lab11/hijack/hardware/hijack_power_supply/rev_a/HIJACK_A.pdf

A

A

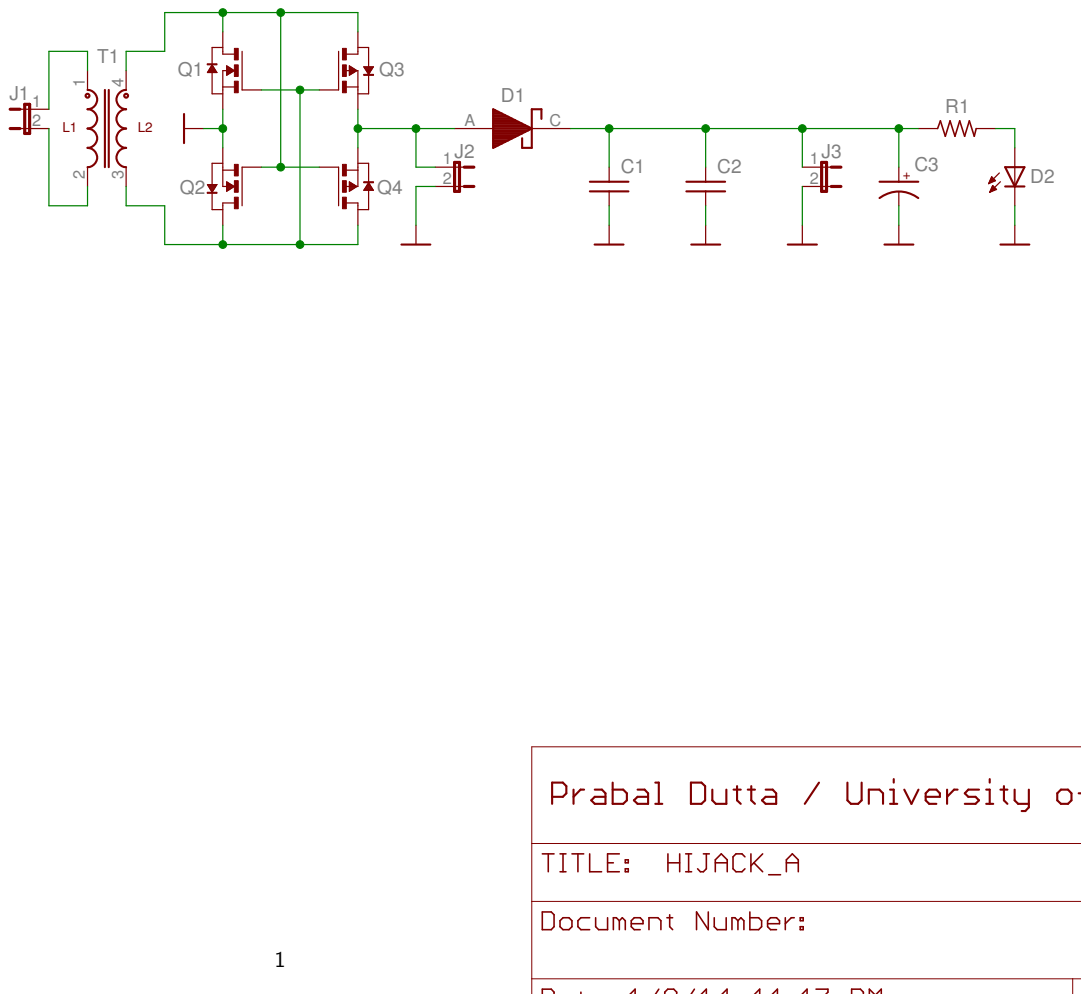
[picture p2: page 1]

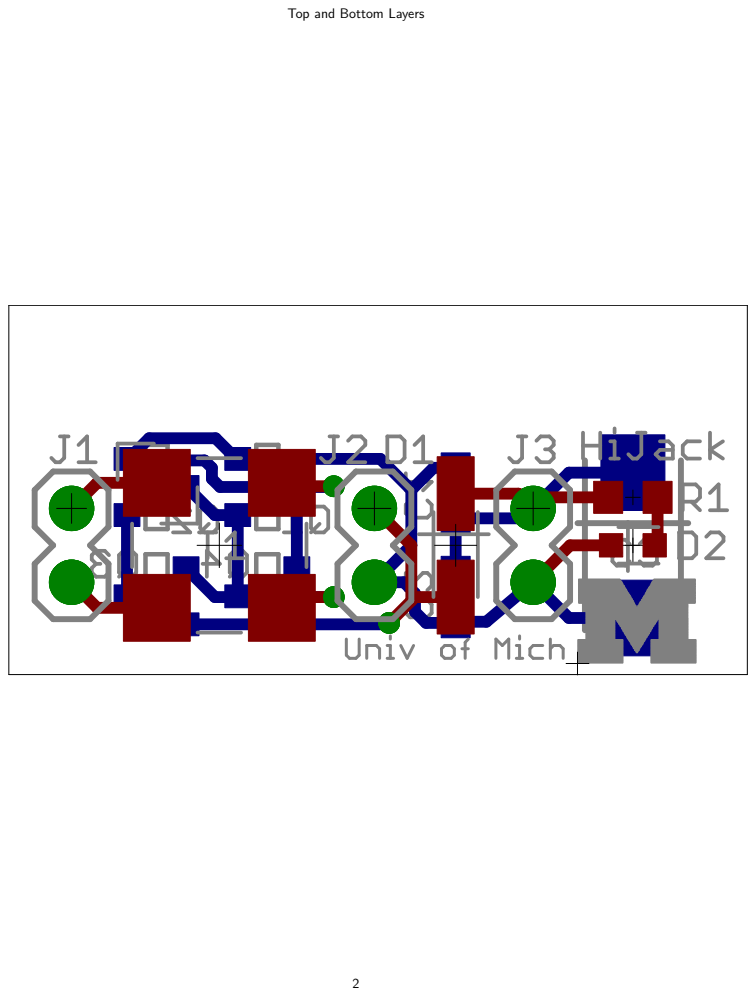
[picture p3: page 2]

Top and Bottom Layers

Top Layer

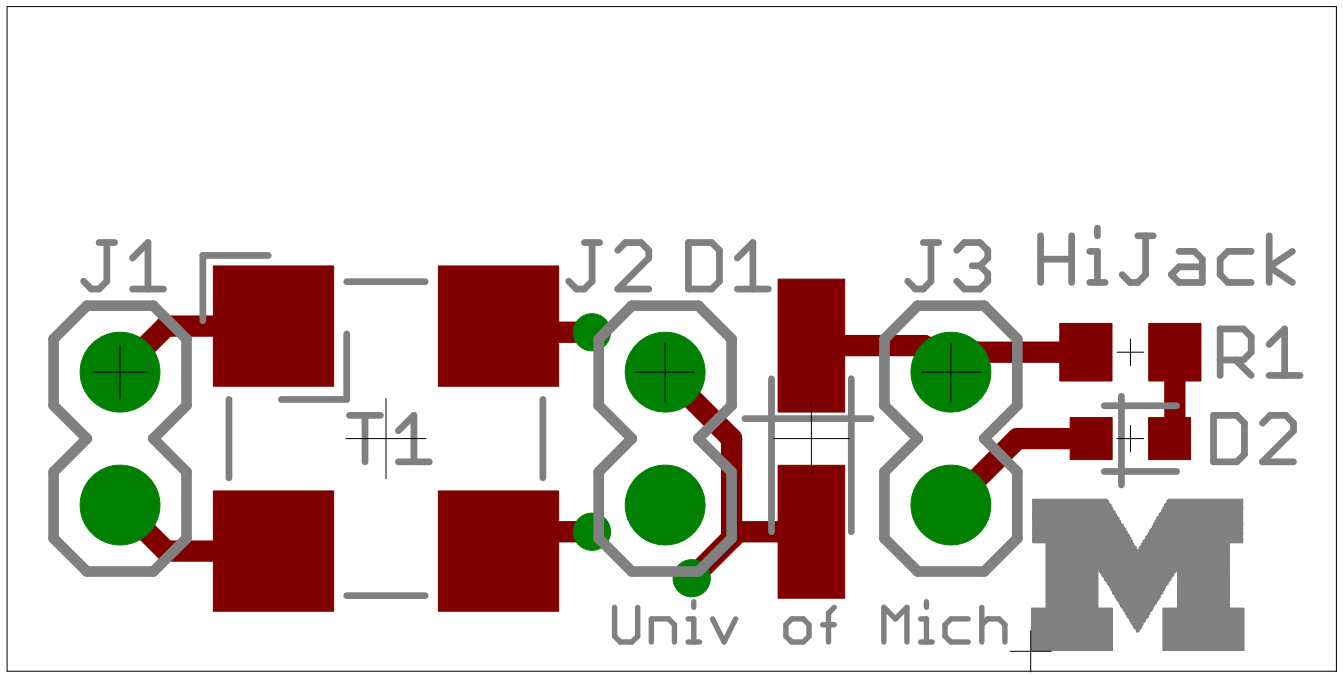
[picture p4: figure]

Bottom Layer

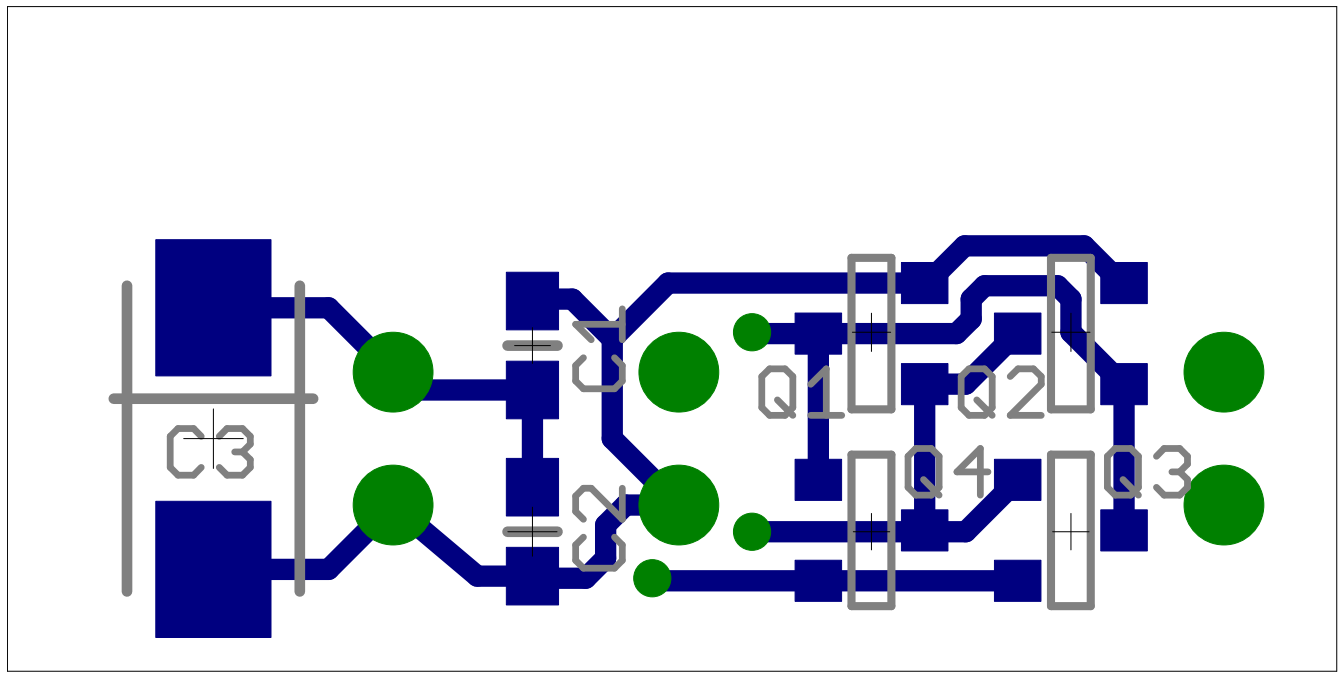
[picture p5: figure]

Top Copper Layer

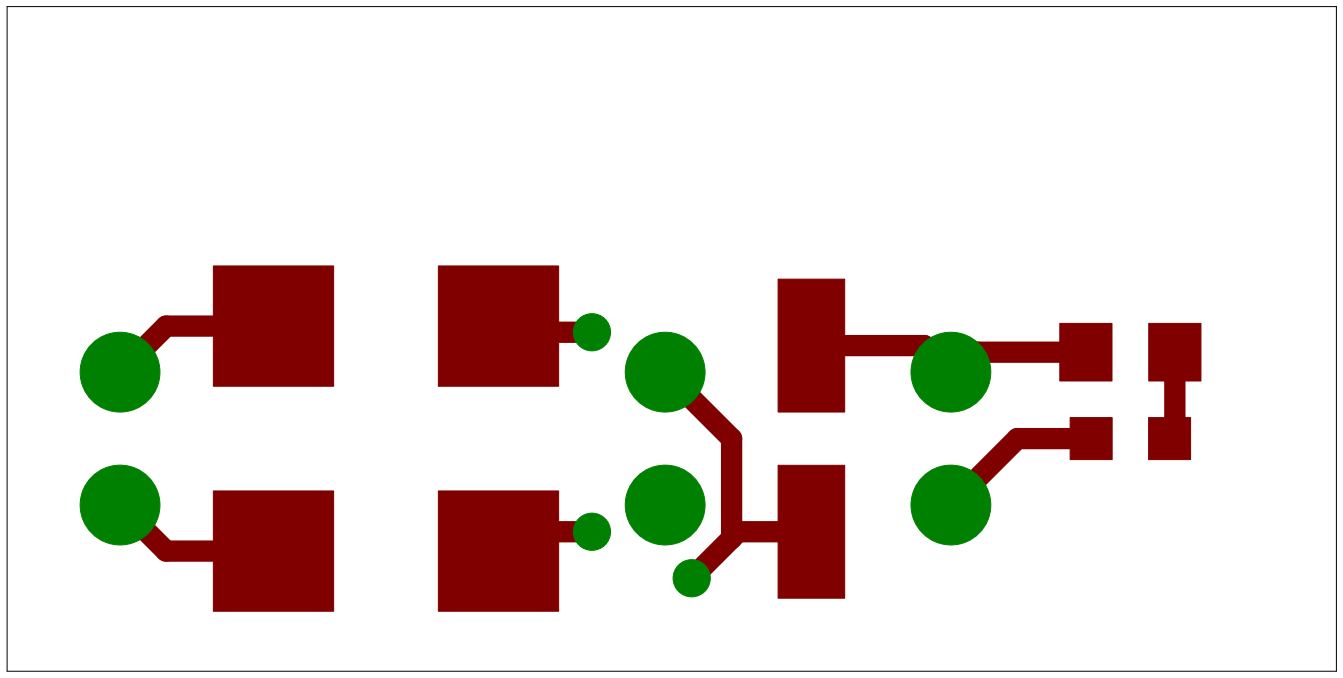
[picture p6: figure]

Bottom Copper Layer

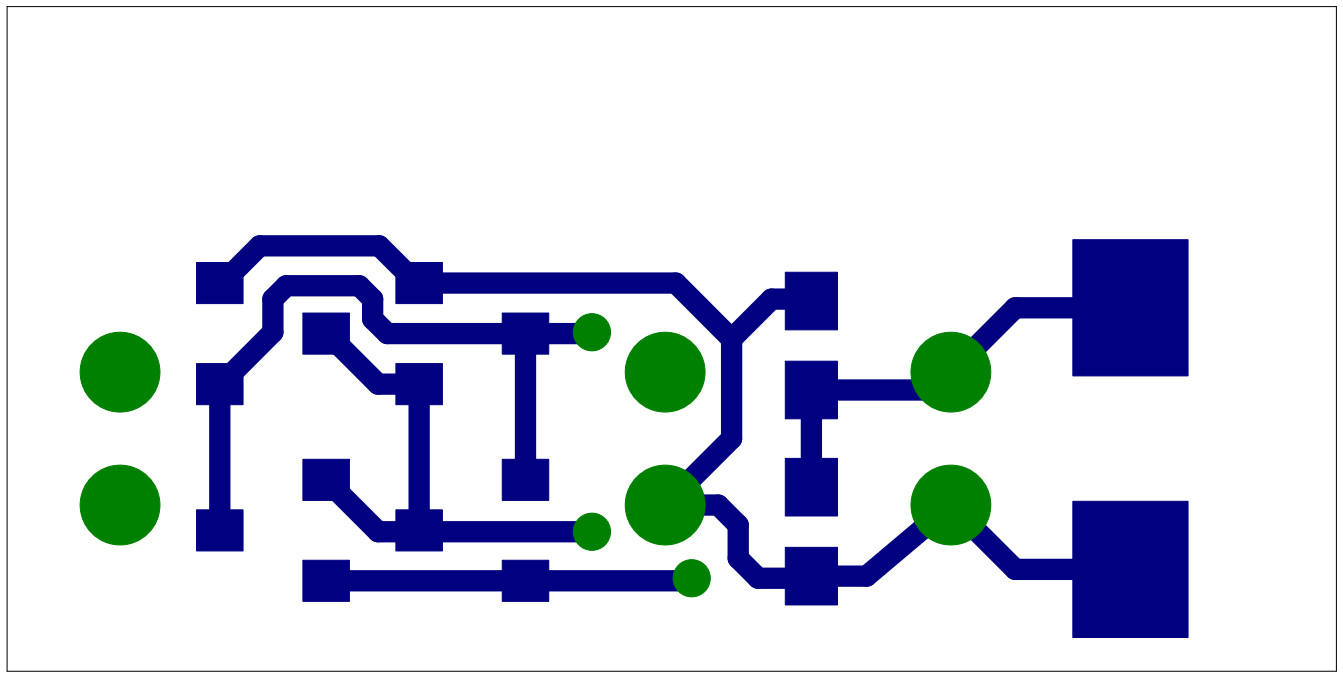
[picture p7: figure]

Top Paste Layer with Silkscreen

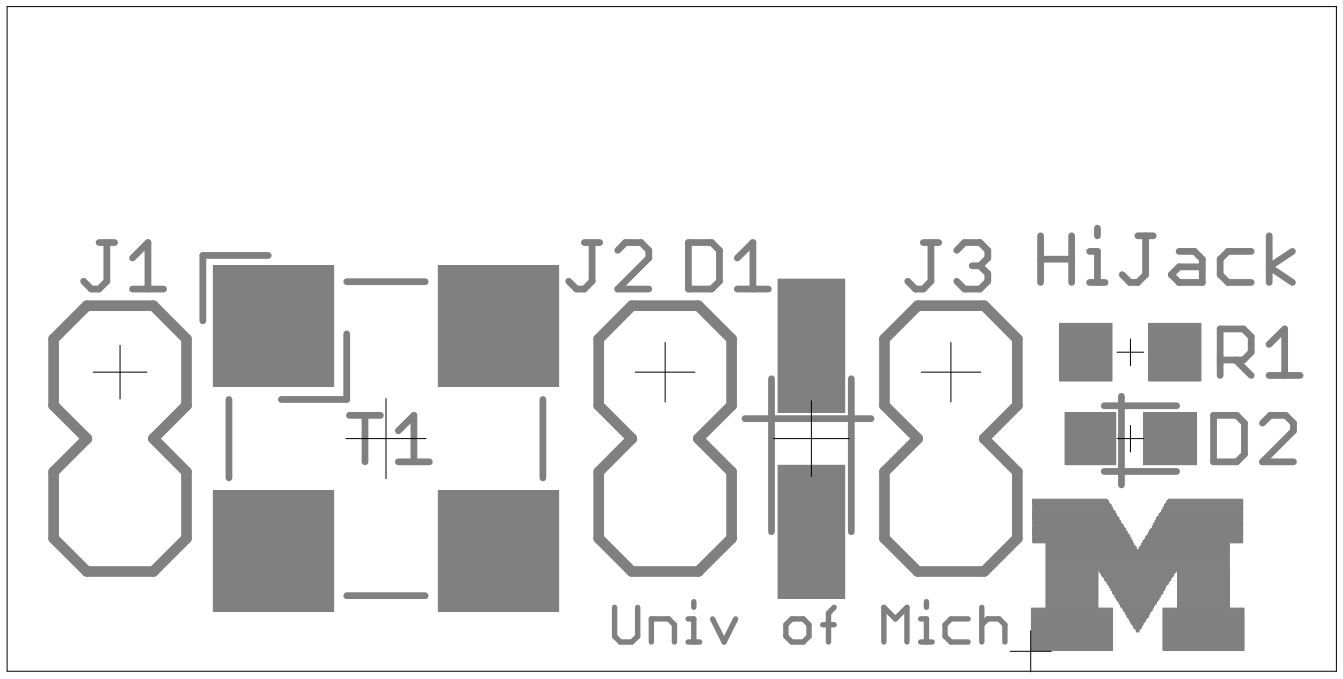
[picture p8: figure]

Bottom Paste Layer with Silkscreen

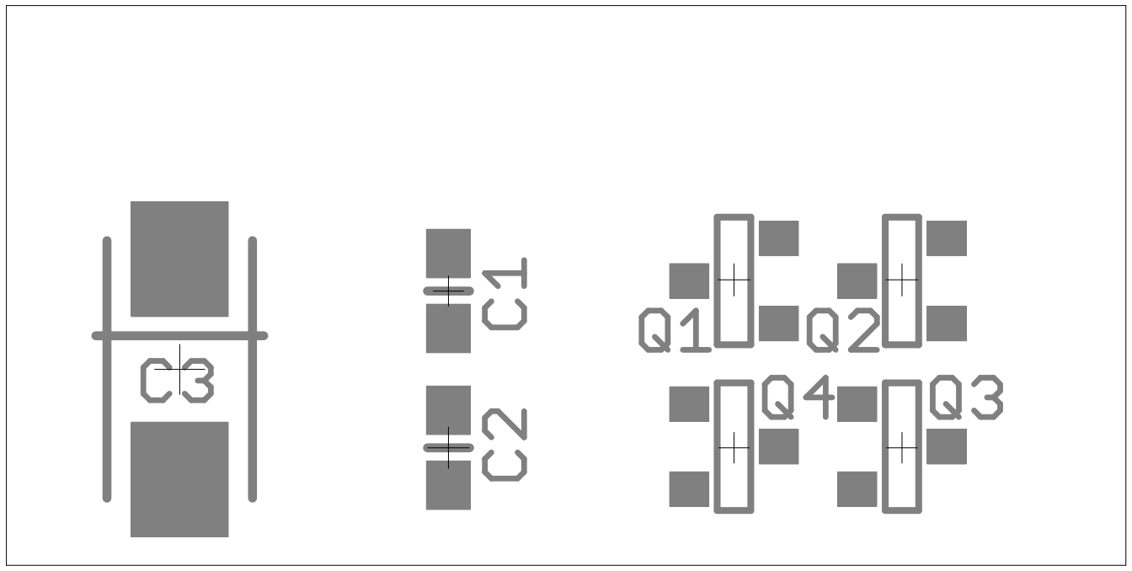
[picture p9: figure]
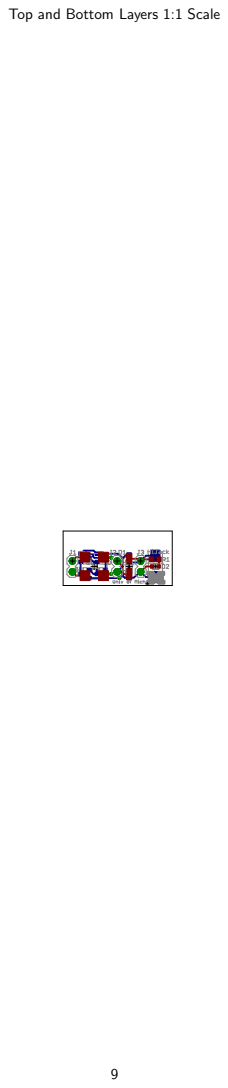
[picture p10: page 9]

Top and Bottom Layers 1:1 Scale

Top Layer 1:1 Scale

Bottom Copper Layer 1:1 Scale
