lab11/hijack/hardware/hijack_power_supply/rev_a/HIJACK_A_pcb.png

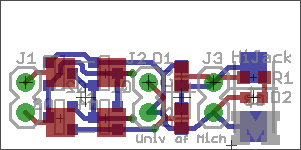
hardware/hijack_power_supply/rev_a/HIJACK_A_pcb.png
