lab11/hijack/hardware/hijack_programmer/rev_a/HiJack_Programmer_pcb.png

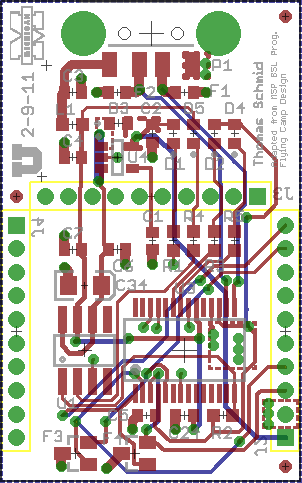
hardware/hijack_programmer/rev_a/HiJack_Programmer_pcb.png
