lab11/hijack/hardware/hijack_protoboard/rev_a/HiJack_ProtoBoard_pcb.png

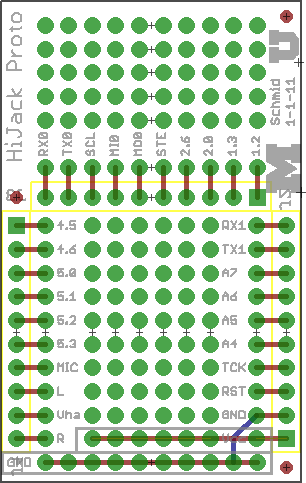
hardware/hijack_protoboard/rev_a/HiJack_ProtoBoard_pcb.png
