lab11/hijack/hardware/hijack_qfn/rev_b/HIJACK_C_pcb.png

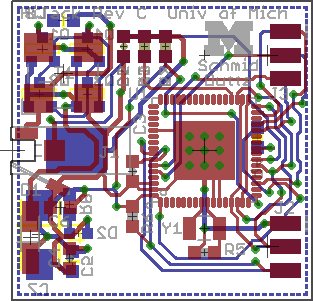
hardware/hijack_qfn/rev_b/HIJACK_C_pcb.png
