lab11/hijack/case/case_v3.stl

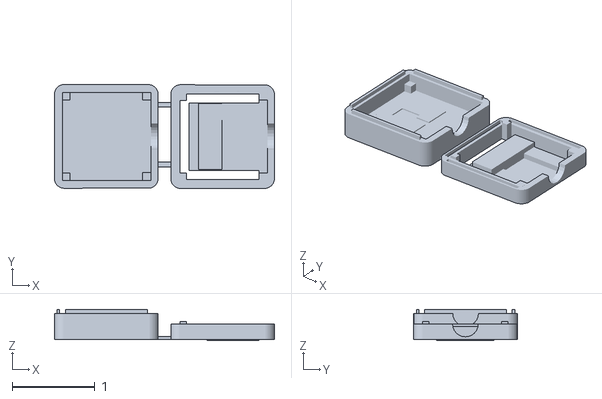
[picture p15: CAD file, 2014-01-10]
case/case_v3.stl
2.65 x 1.25 x 0.375
