lab11/hijack/(list of files, cad)

Other CAD files:
case/M.skp
case/case v1.skp
case/case_v2.skp
case/case_v3.skp
case/case_v4.skp
case/case_v5.skp
case/case_v6.skp
case/case_v6_bot.skp
case/case_v6_top.skp
case/case_v7_bot.skp
case/case_v7_top.skp
case/underside small.skp
case/underside.skp
