lab11/hijack/hardware/hijack_qfn/rev_b/HIJACK_C.pdf

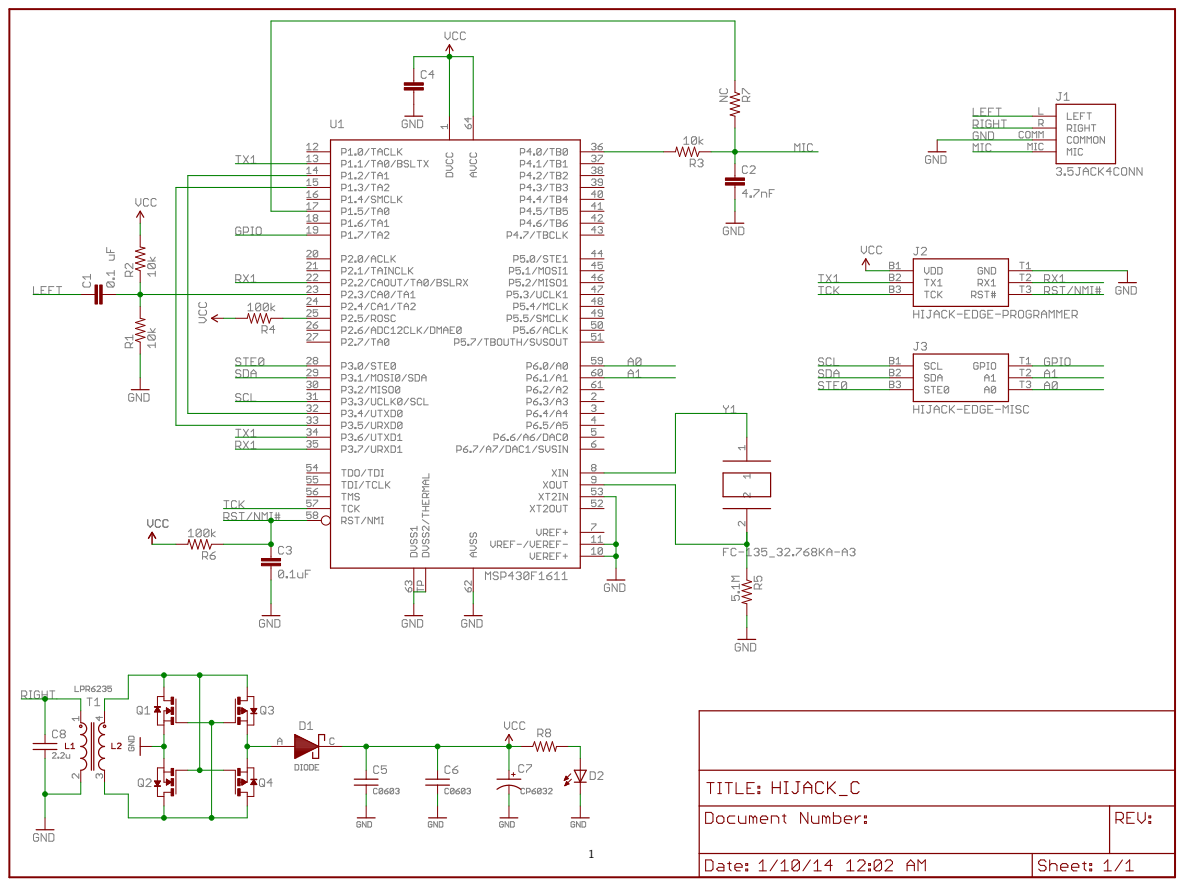
[picture p16: page 1]

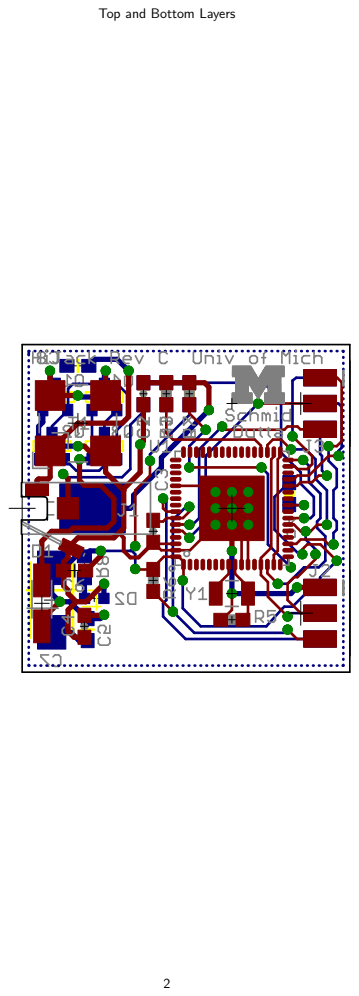
[picture p17: page 2]

Top and Bottom Layers

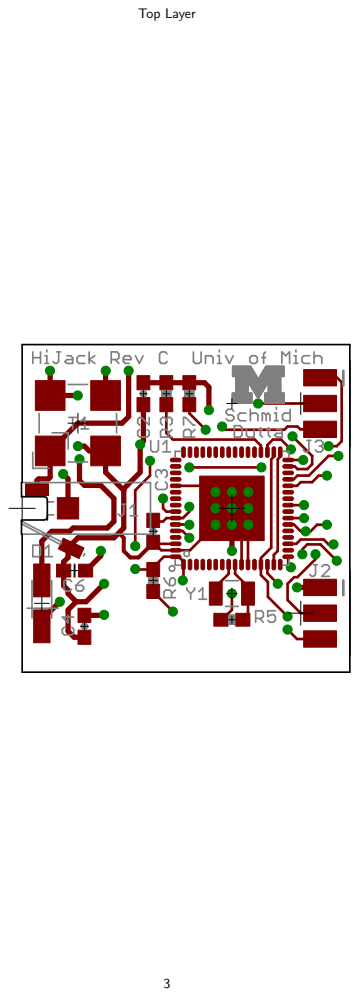
[picture p18: page 3]
Top Layer

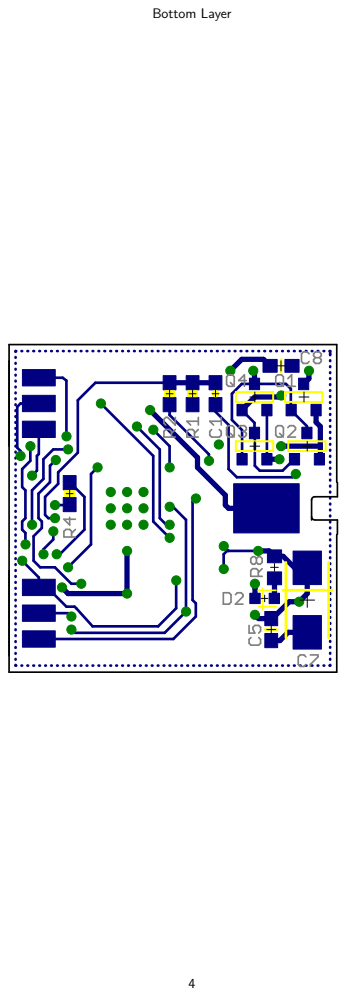
[picture p19: page 4]
Bottom Layer

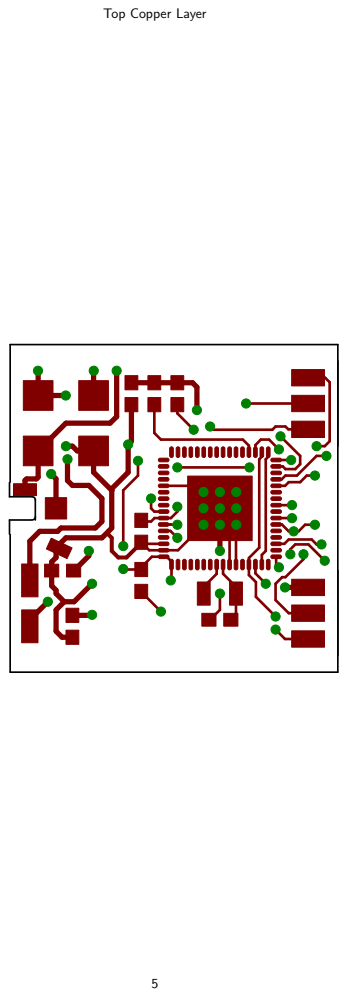
[picture p20: page 5]

Top Copper Layer

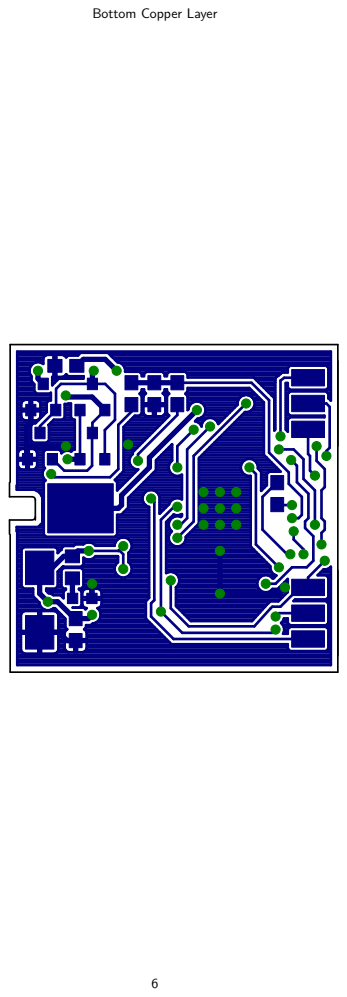
[picture p21: page 6]

Bottom Copper Layer

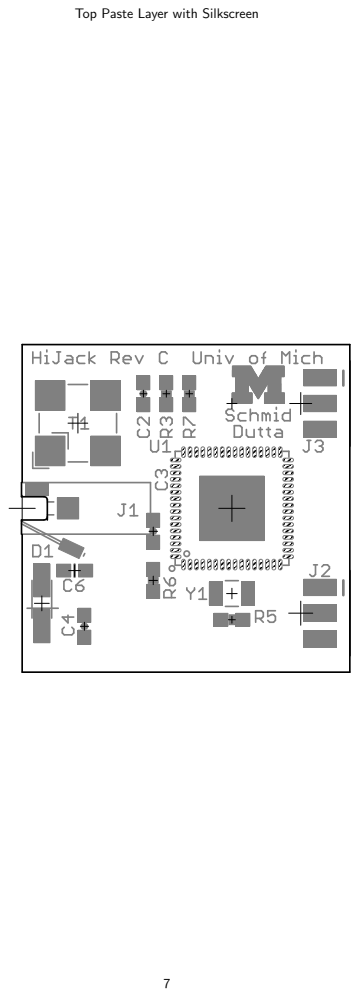
[picture p22: page 7]

Top Paste Layer with Silkscreen

Bottom Paste Layer with Silkscreen

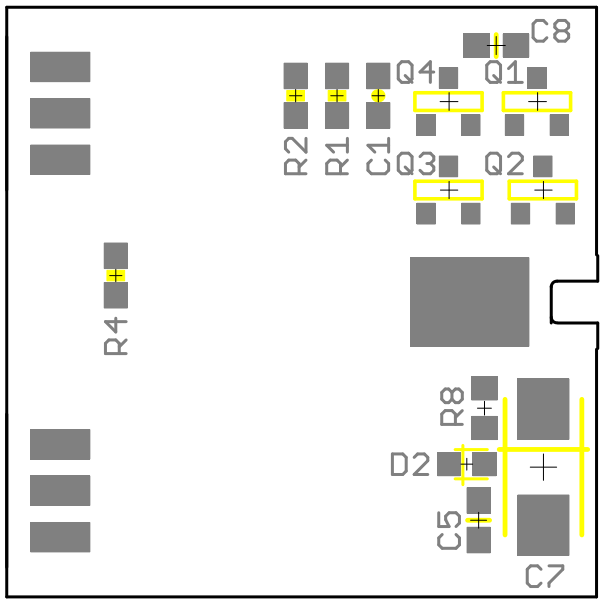
[picture p23: figure]
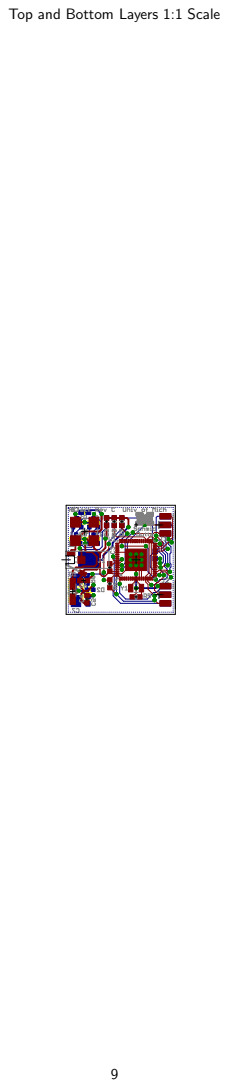
[picture p24: page 9]

Top and Bottom Layers 1:1 Scale

Top Layer 1:1 Scale

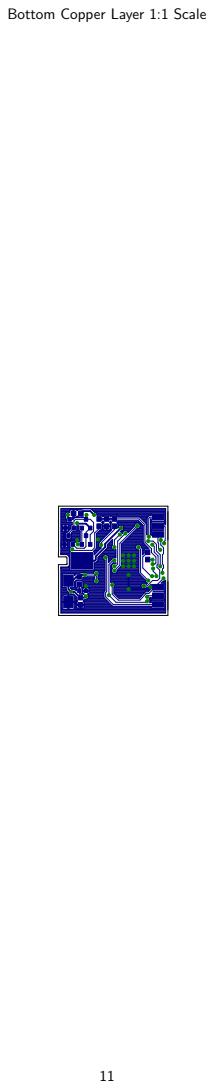
[picture p25: page 11]

Bottom Copper Layer 1:1 Scale
