lab11/hijack/hardware/hijack_protoboard/rev_a/HiJack_ProtoBoard.pdf

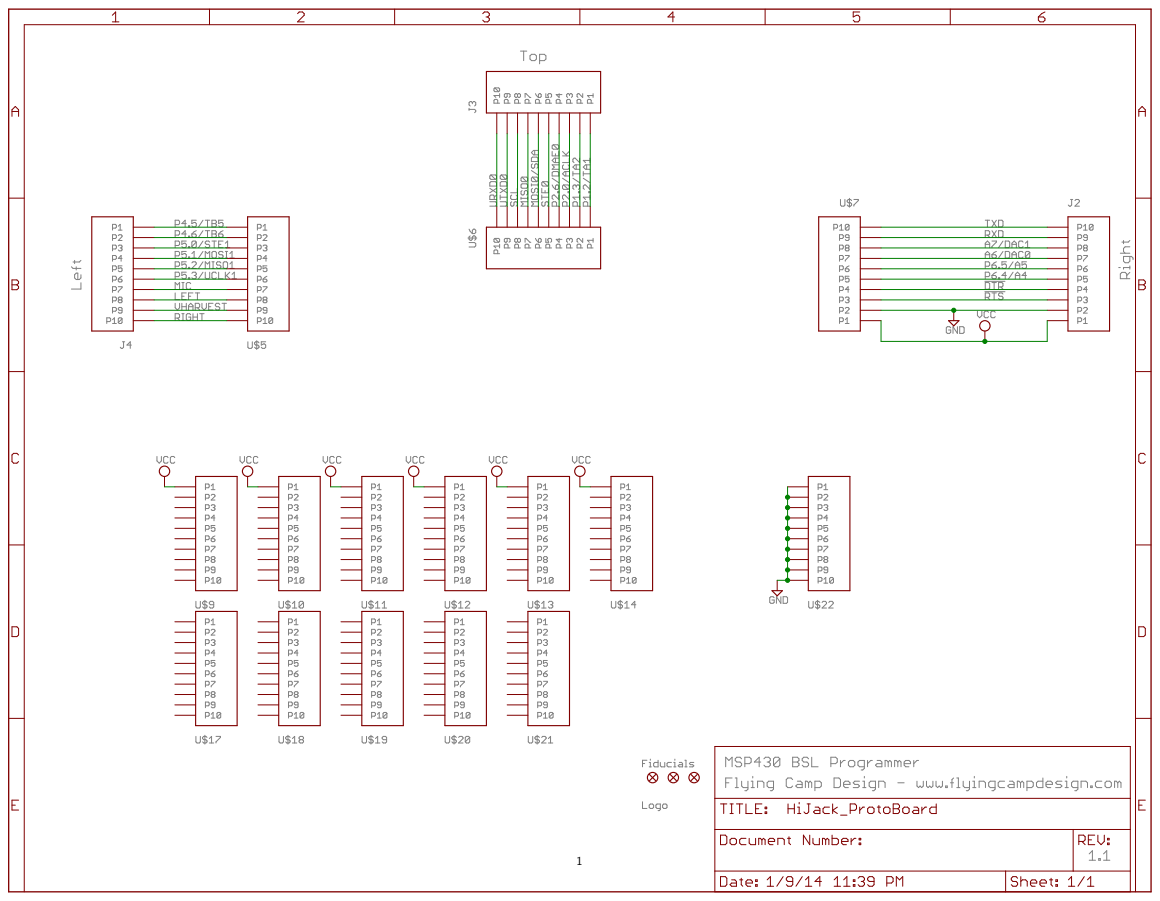
[picture p26: page 1]

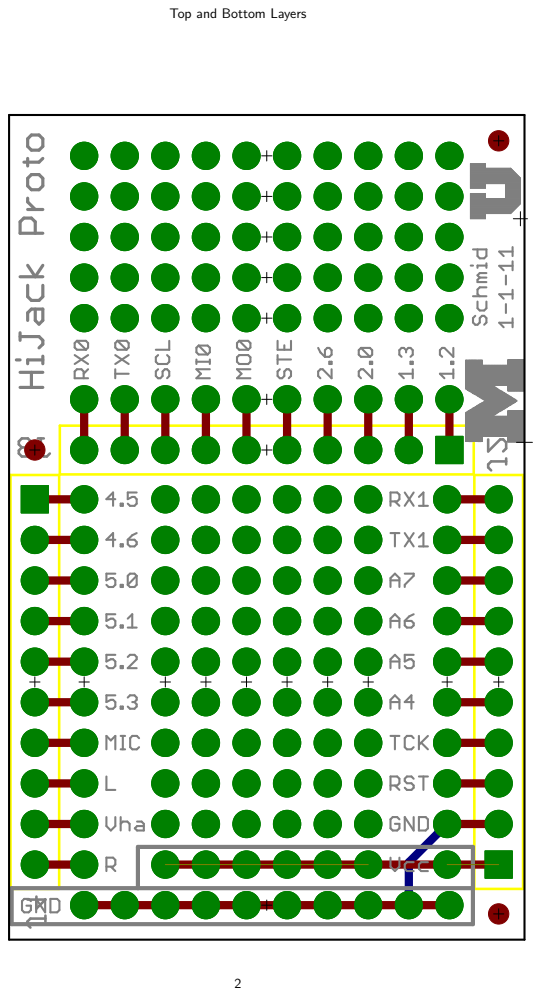
[picture p27: page 2]

Top and Bottom Layers

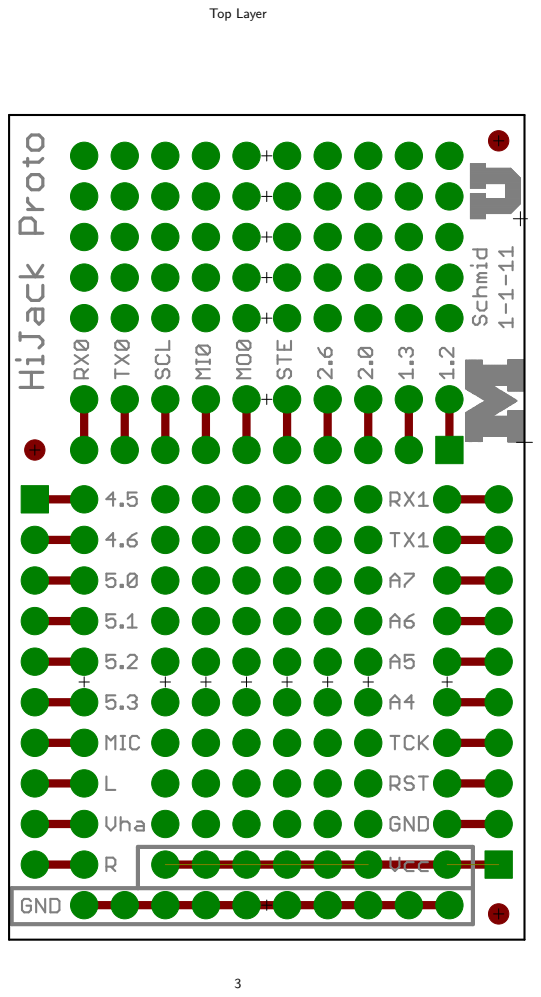
[picture p28: page 3]
Top Layer

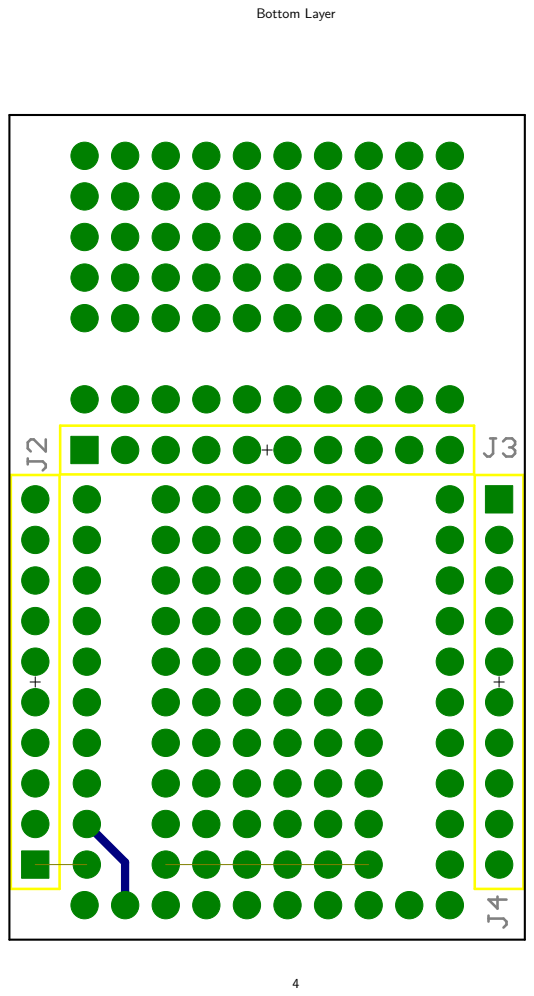
[picture p29: page 4]
Bottom Layer

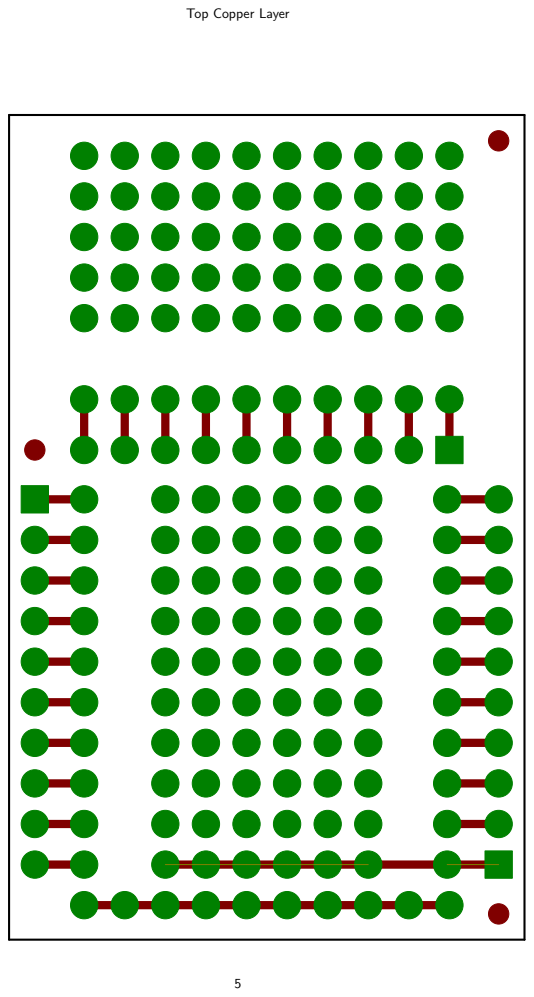
[picture p30: page 5]

Top Copper Layer

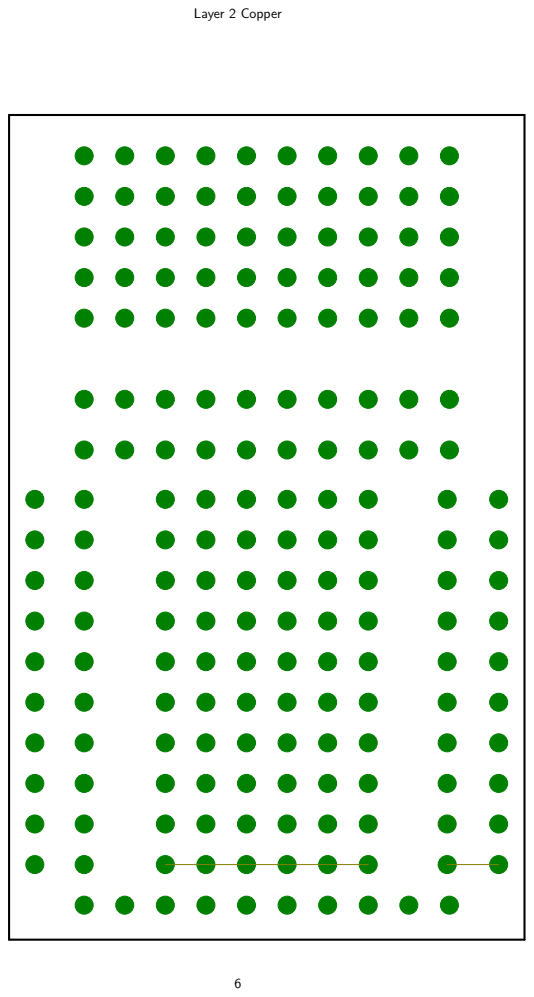
[picture p31: page 6]
Layer 2 Copper

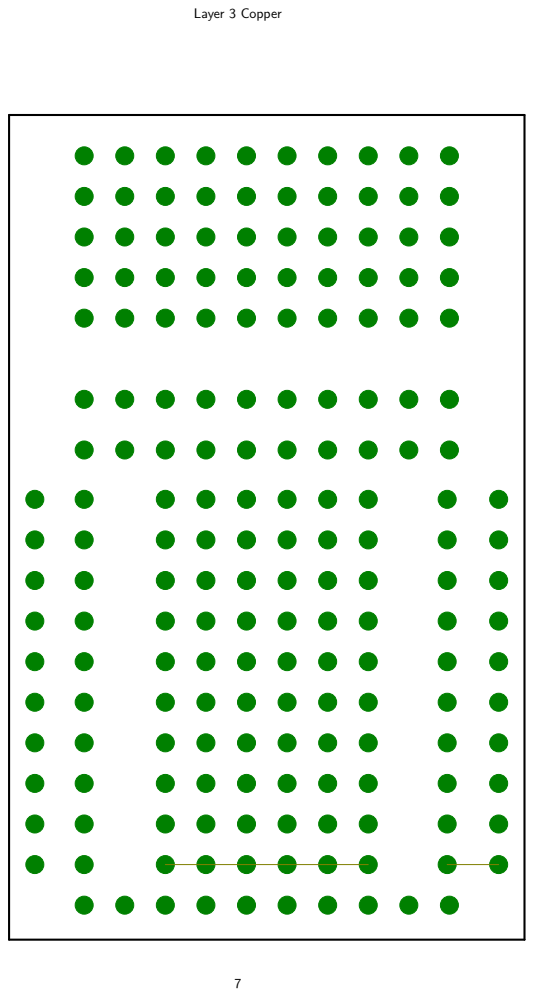
[picture p32: page 7]
Layer 3 Copper

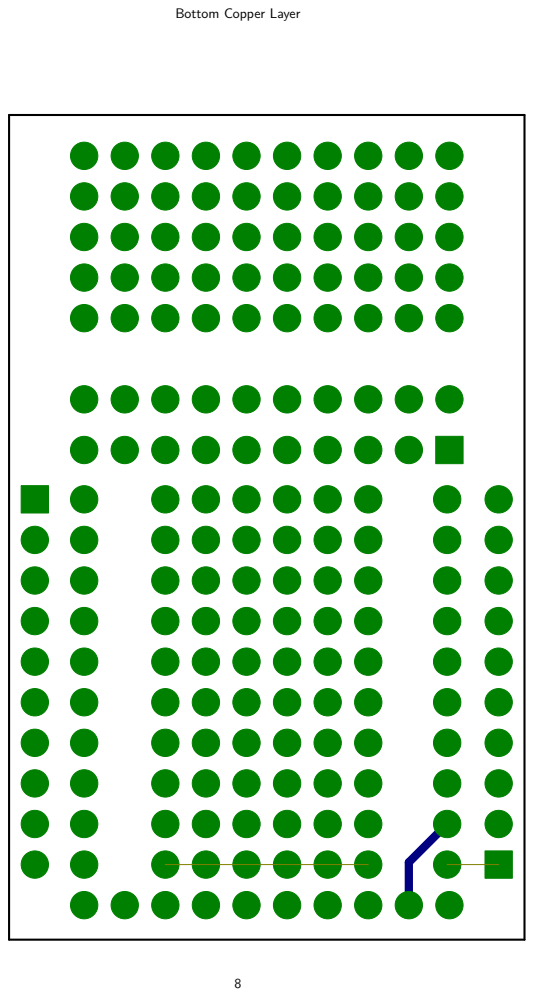
[picture p33: page 8]

Bottom Copper Layer

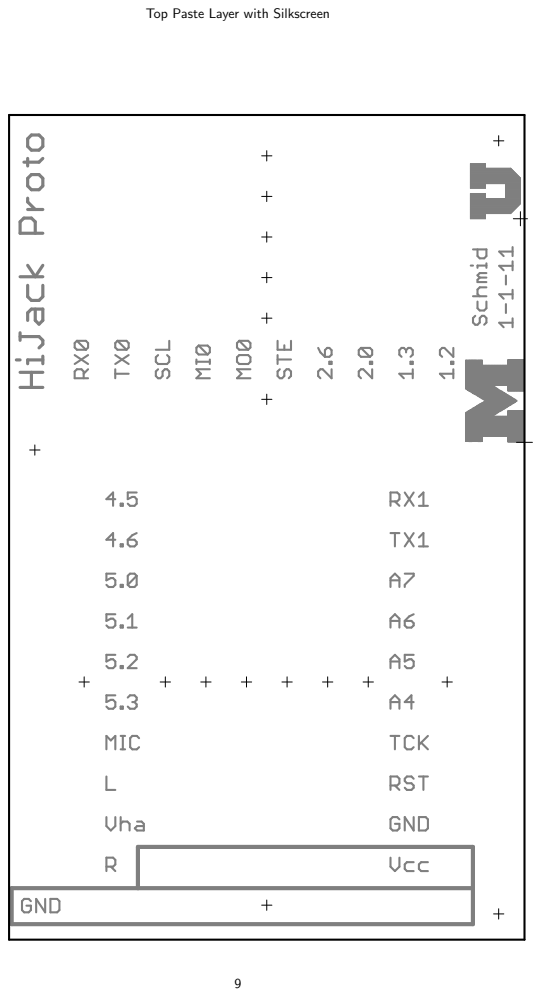
[picture p34: page 9]

Top Paste Layer with Silkscreen

Bottom Paste Layer with Silkscreen

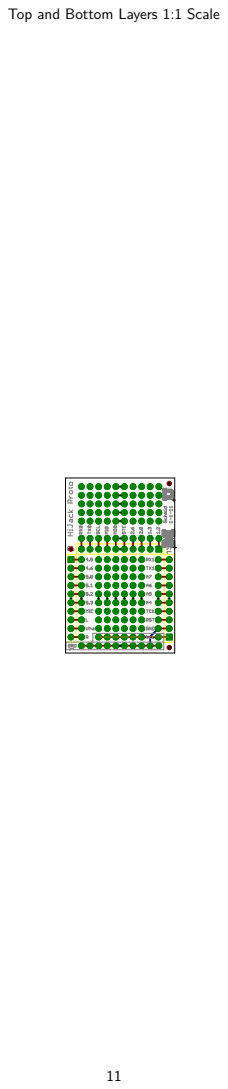
[picture p35: page 11]

Top and Bottom Layers 1:1 Scale

Top Layer 1:1 Scale

Layer 2 Copper 1:1 Scale

Layer 3 Copper 1:1 Scale

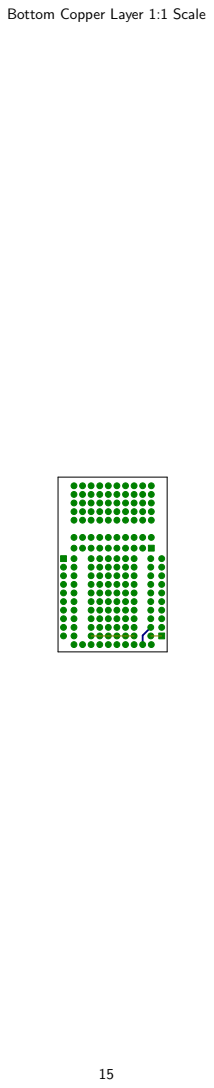
[picture p36: page 15]

Bottom Copper Layer 1:1 Scale
