lab11/hijack/hardware/hijack/rev_d/HIJACK_LQPF_D_SCH.pdf

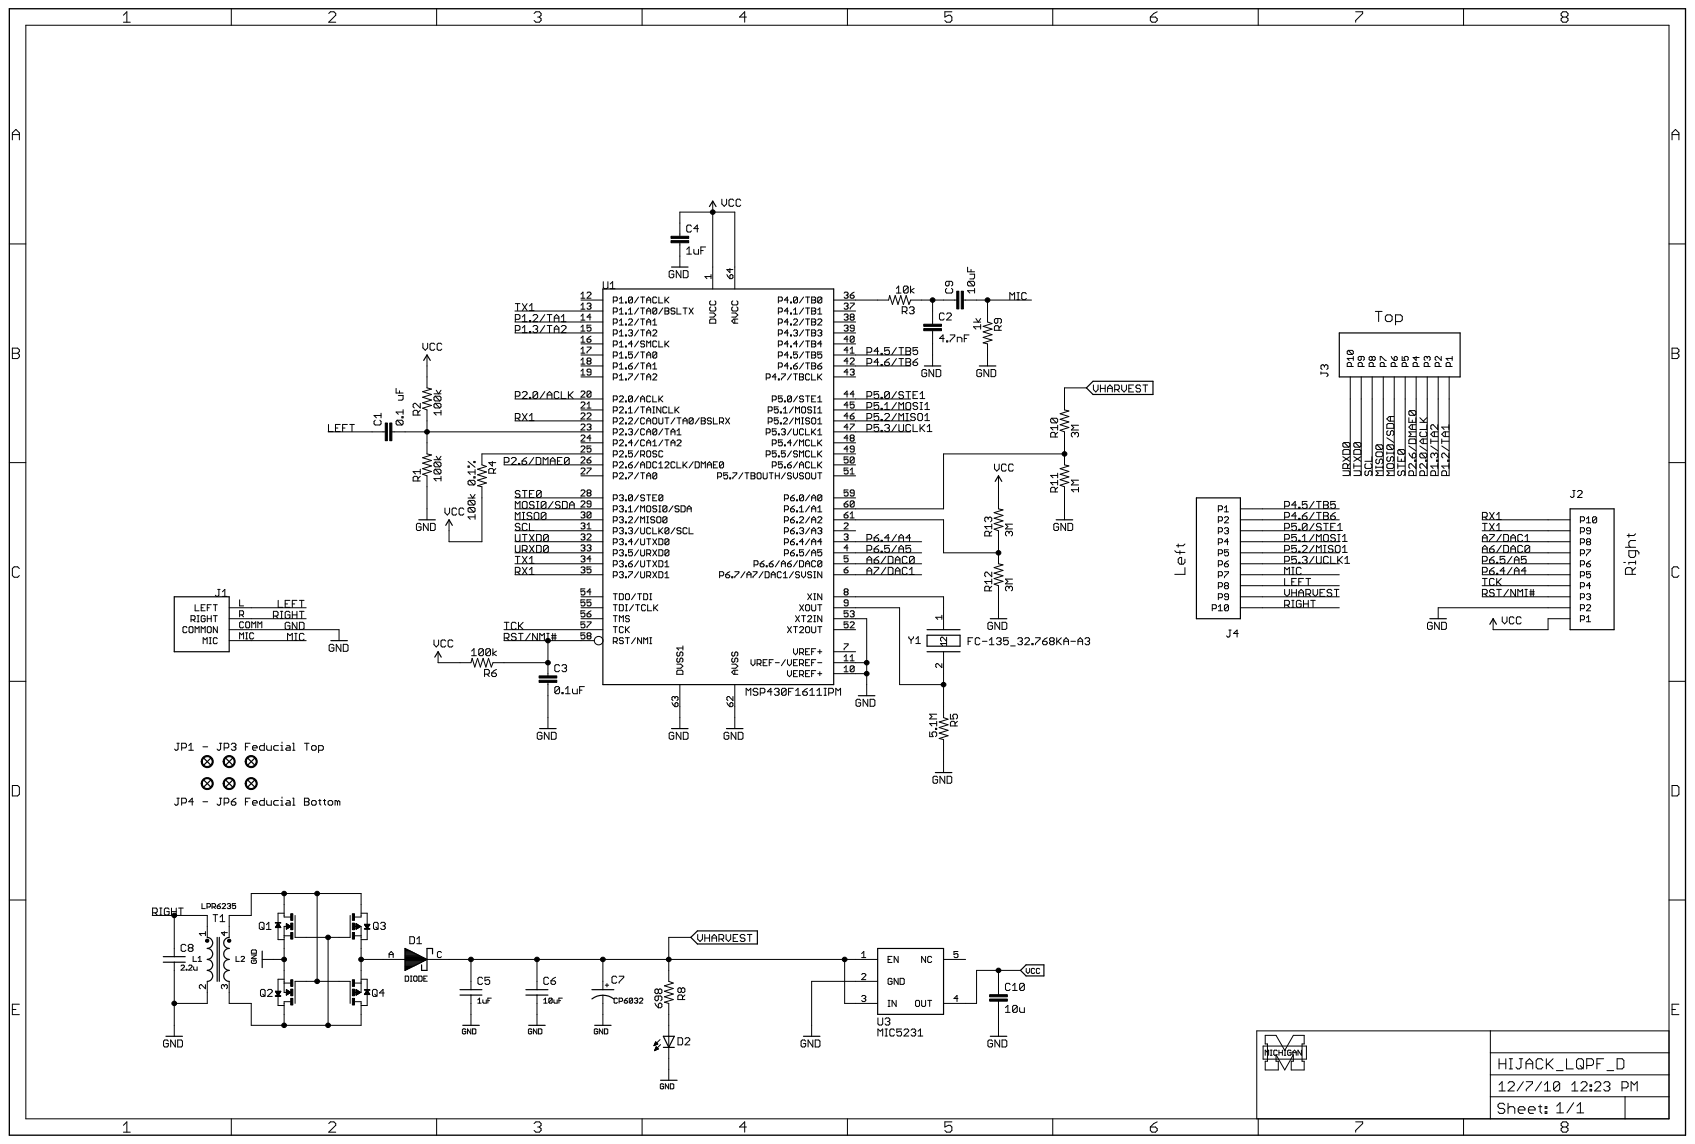
[picture p49: page 1]
