lab11/hijack/hardware/hijack_qfn/rev_a/HIJACK_B.pdf

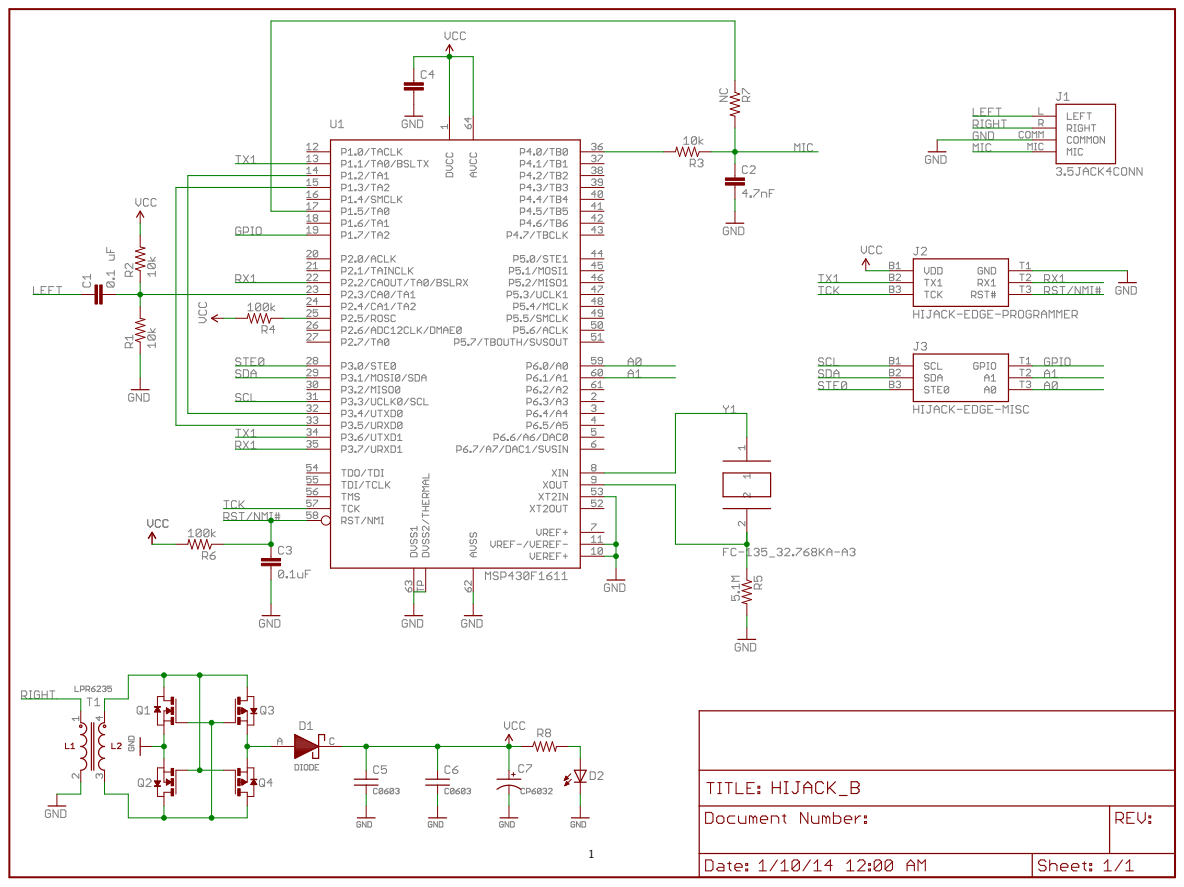
[picture p50: page 1]

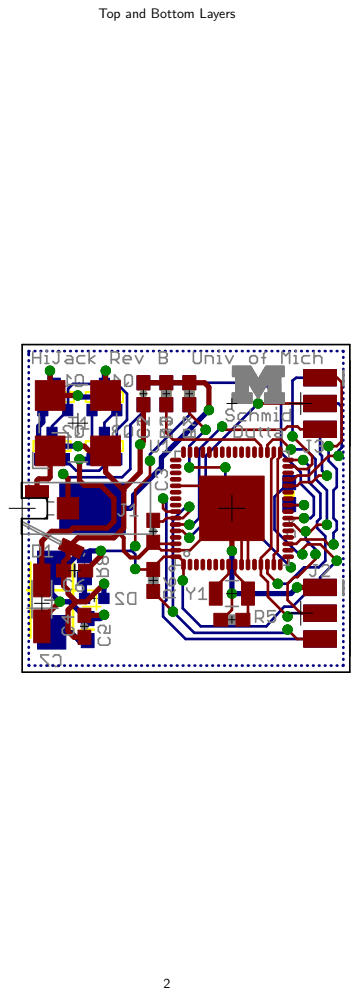
[picture p51: page 2]

Top and Bottom Layers

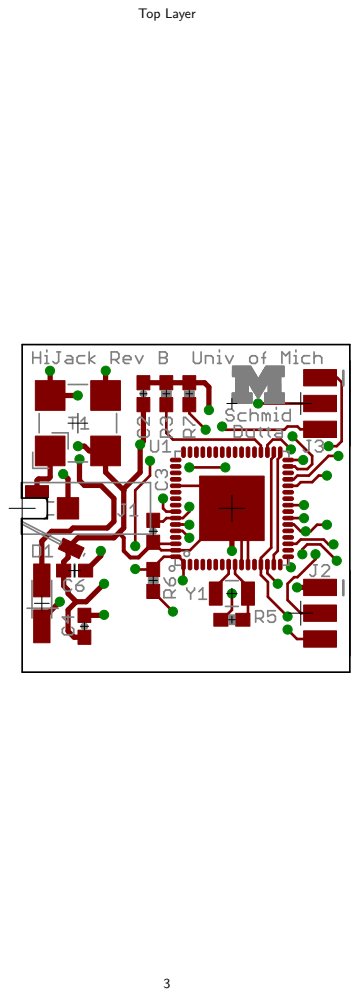
[picture p52: page 3]
Top Layer

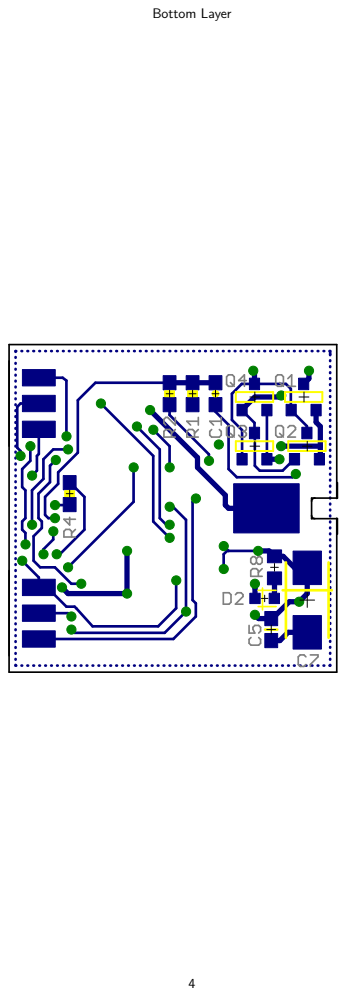
[picture p53: page 4]
Bottom Layer

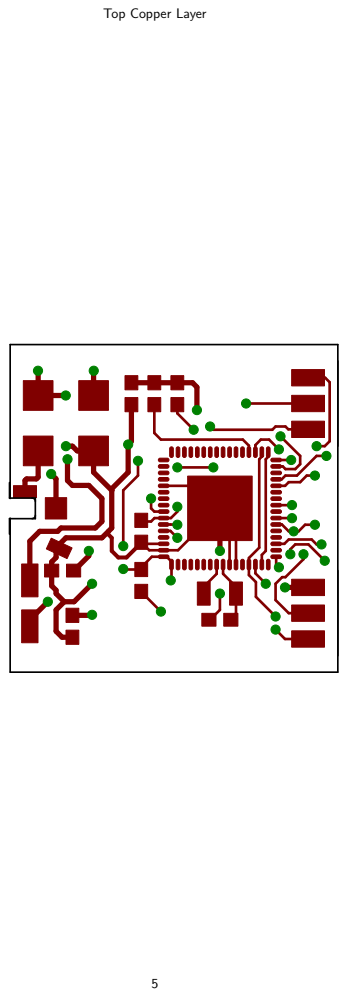
[picture p54: page 5]

Top Copper Layer

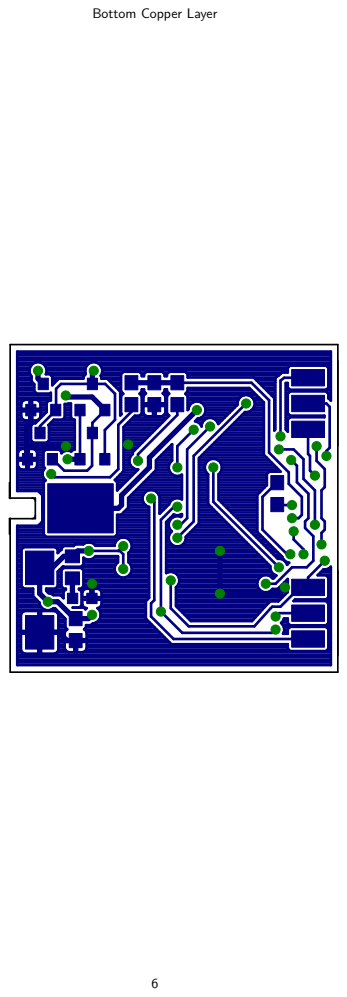
[picture p55: page 6]

Bottom Copper Layer

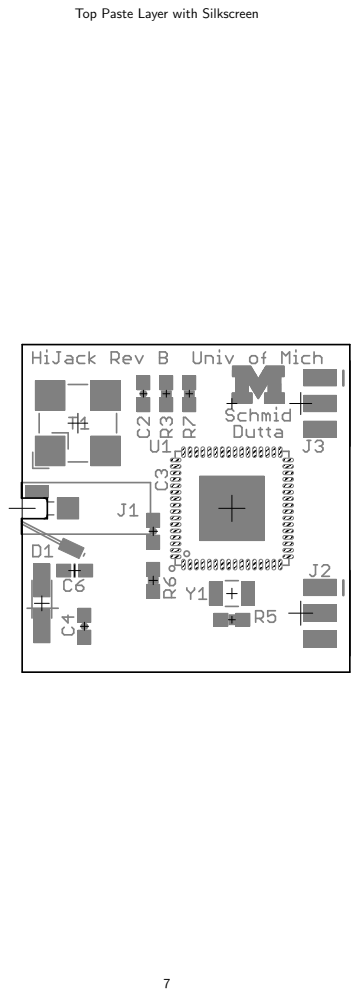
[picture p56: page 7]

Top Paste Layer with Silkscreen

Bottom Paste Layer with Silkscreen

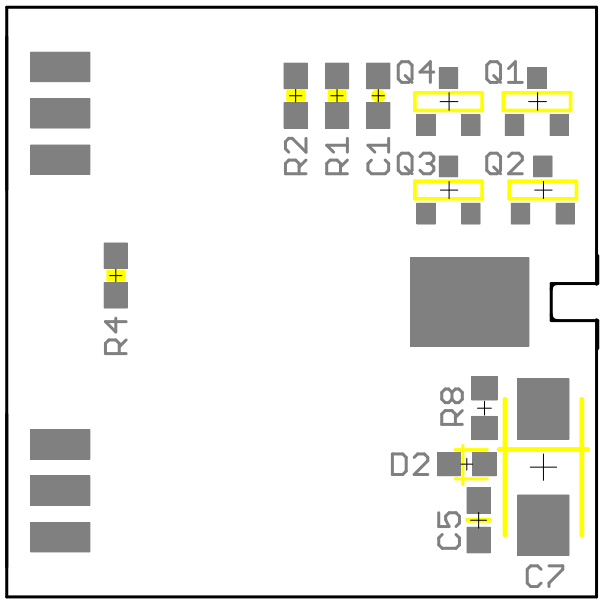
[picture p57: figure]
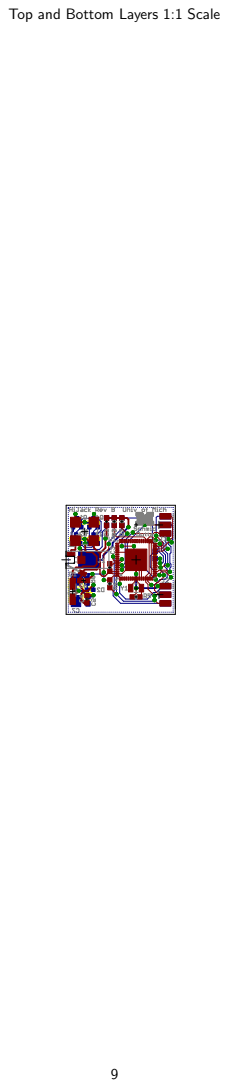
[picture p58: page 9]

Top and Bottom Layers 1:1 Scale

Top Layer 1:1 Scale

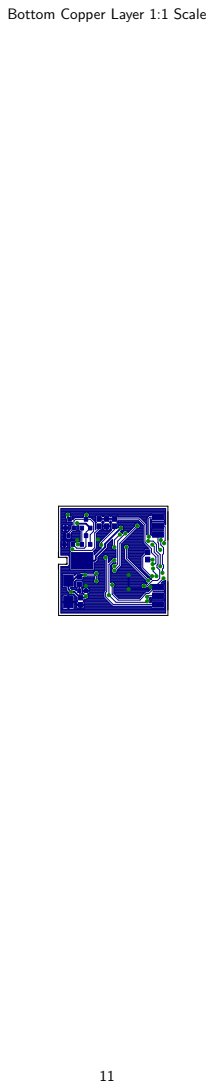
[picture p59: page 11]

Bottom Copper Layer 1:1 Scale
