lab11/hijack/hardware/hijack/rev_a/HIJACK_LQPF_A.pdf

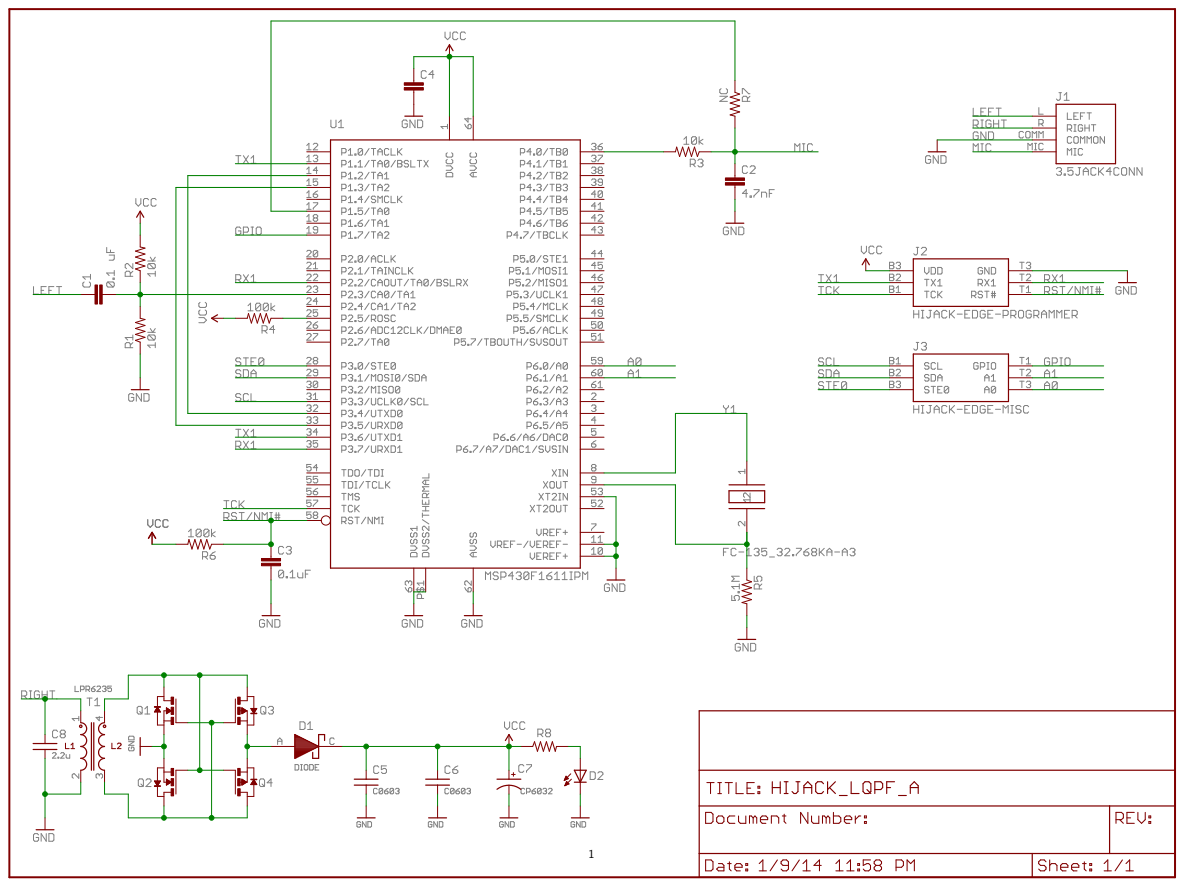
[picture p60: page 1]

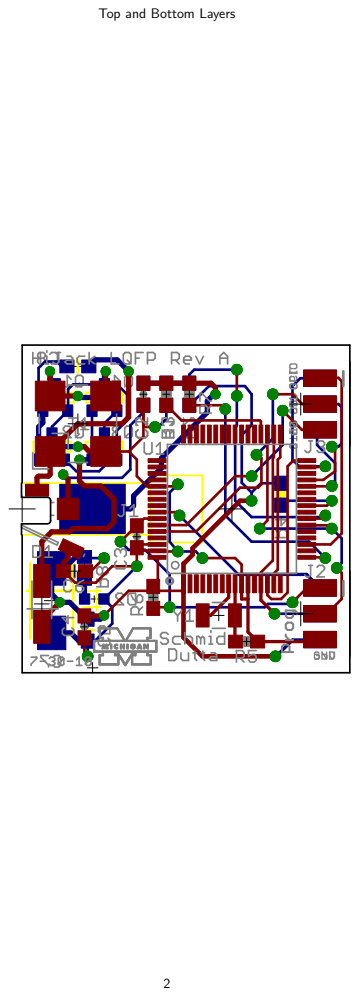
[picture p61: page 2]

Top and Bottom Layers

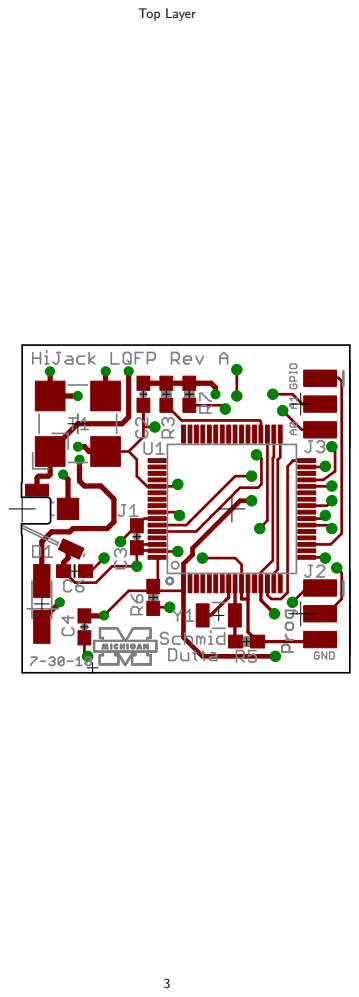
[picture p62: page 3]
Top Layer

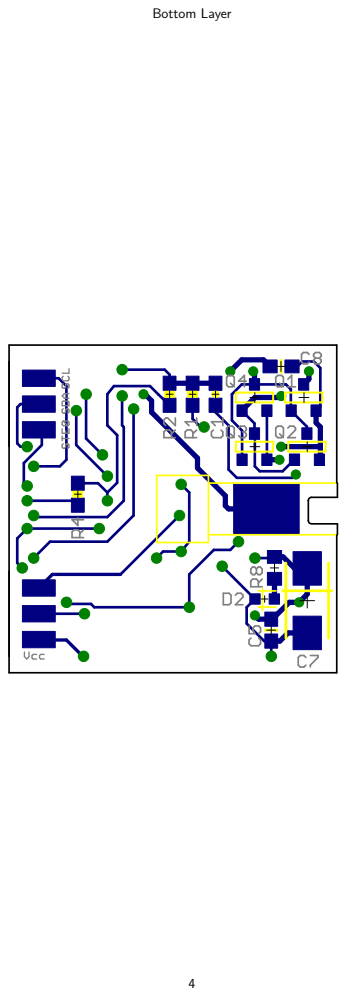
[picture p63: page 4]
Bottom Layer

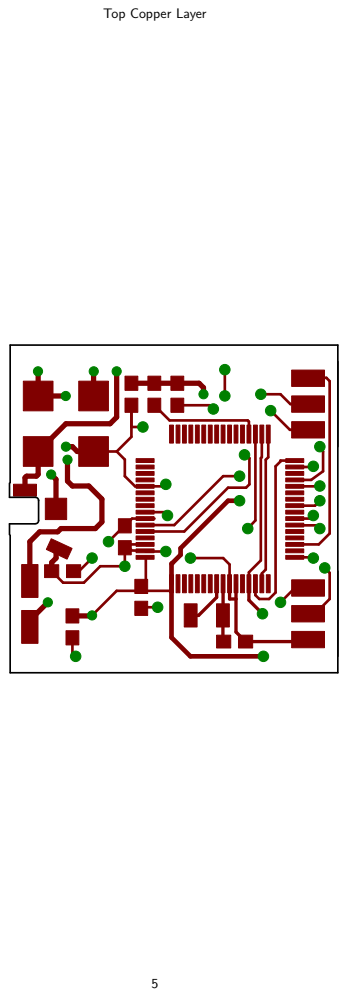
[picture p64: page 5]

Top Copper Layer

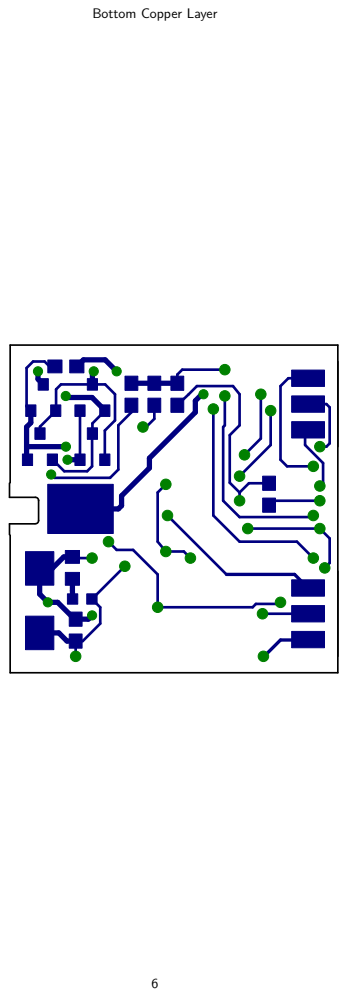
[picture p65: page 6]

Bottom Copper Layer

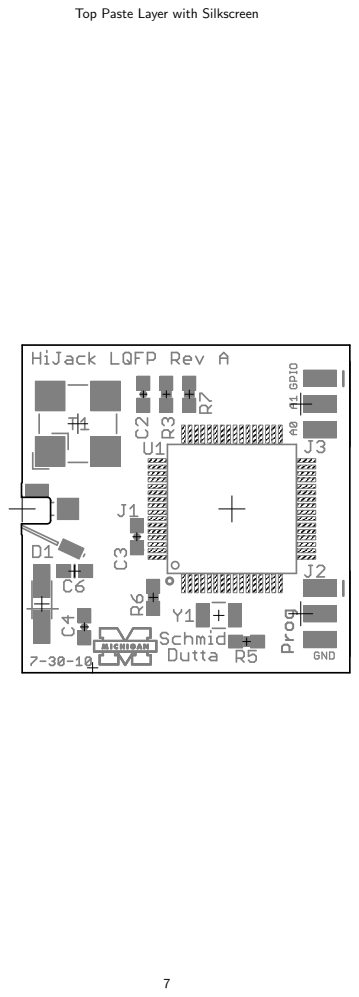
[picture p66: page 7]

Top Paste Layer with Silkscreen

Bottom Paste Layer with Silkscreen

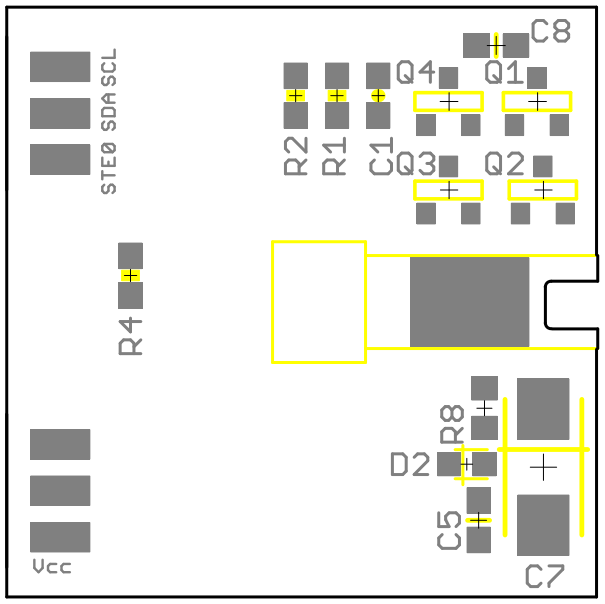
[picture p67: figure]
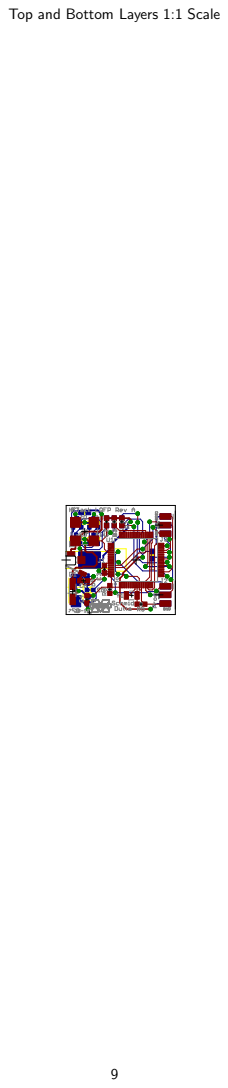
[picture p68: page 9]

Top and Bottom Layers 1:1 Scale

Top Layer 1:1 Scale

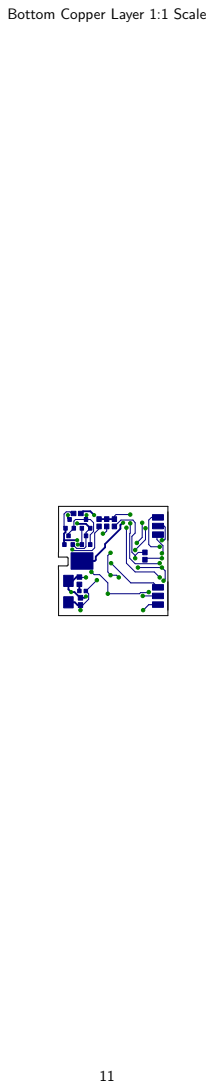
[picture p69: page 11]

Bottom Copper Layer 1:1 Scale
