lab11/hijack/hardware/hijack/rev_b/HIJACK_LQPF_B.pdf

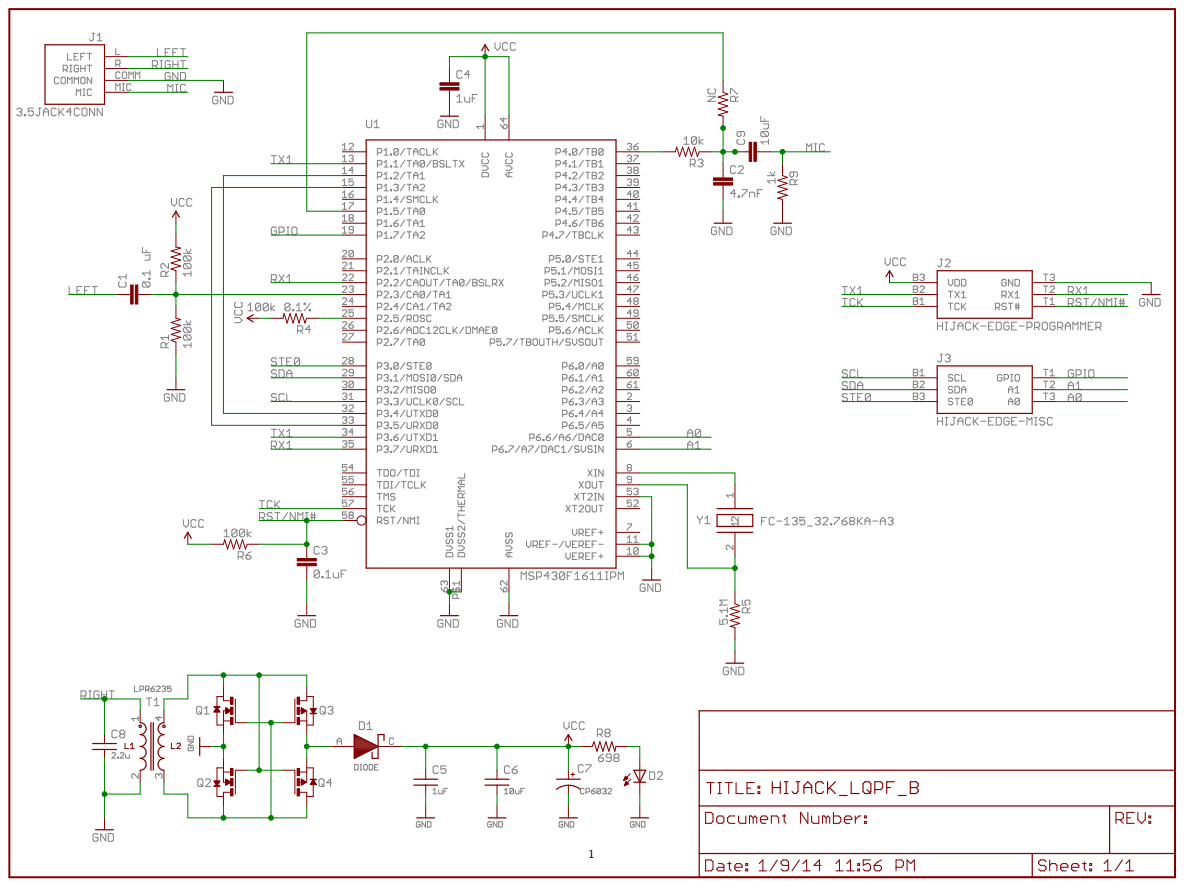
[picture p70: page 1]

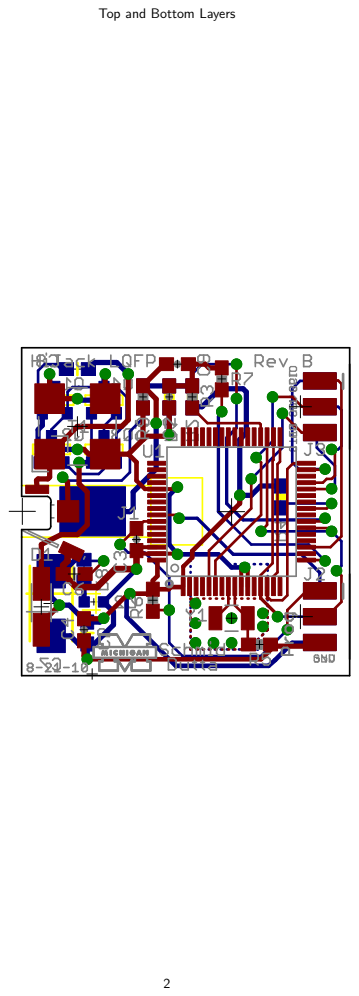
[picture p71: page 2]

Top and Bottom Layers

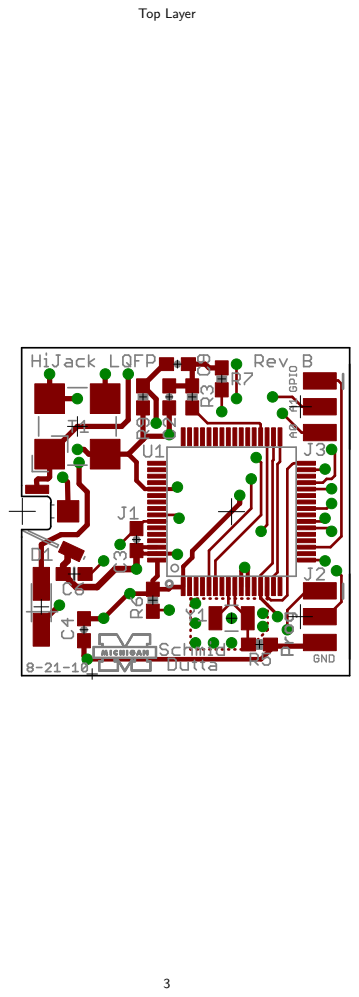
[picture p72: page 3]
Top Layer

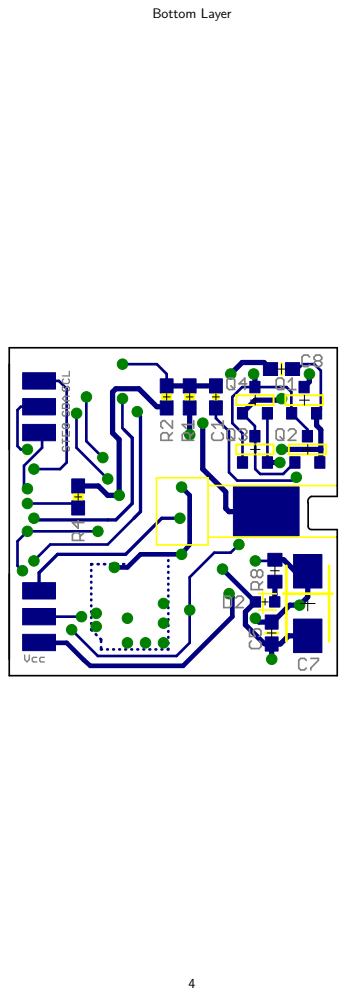
[picture p73: page 4]
Bottom Layer

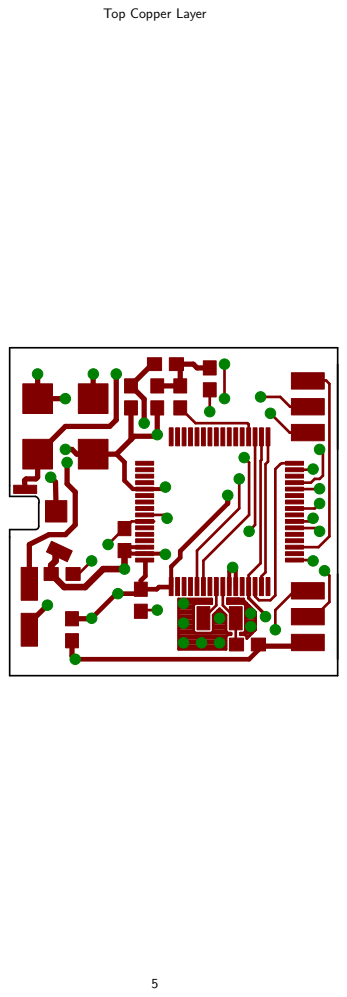
[picture p74: page 5]

Top Copper Layer

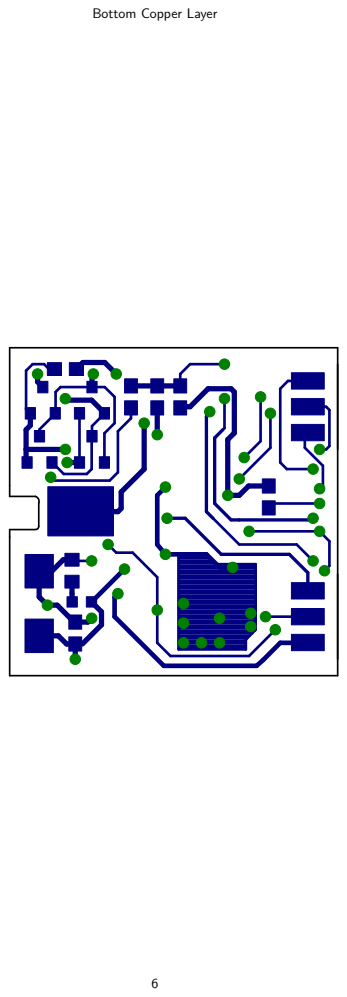
[picture p75: page 6]

Bottom Copper Layer

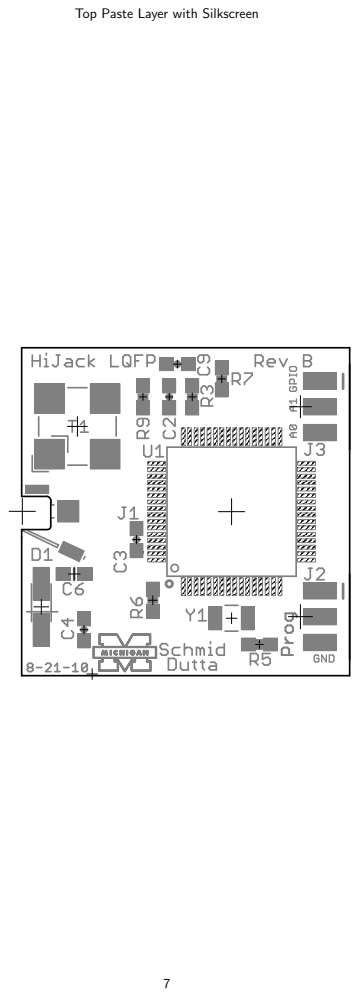
[picture p76: page 7]

Top Paste Layer with Silkscreen

Bottom Paste Layer with Silkscreen

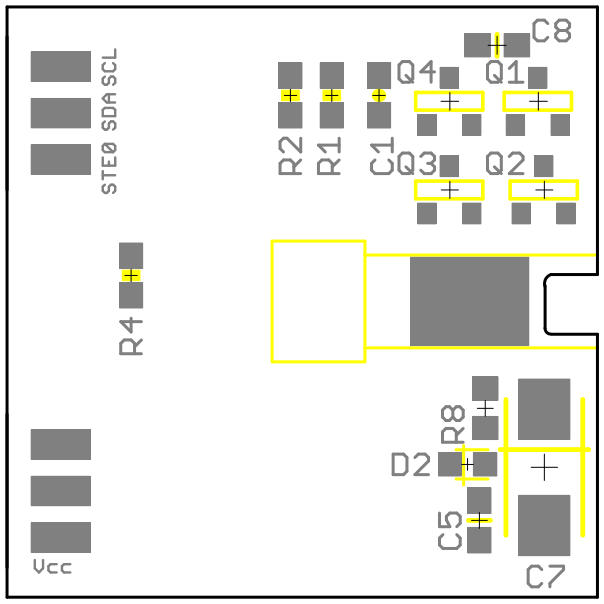
[picture p77: figure]
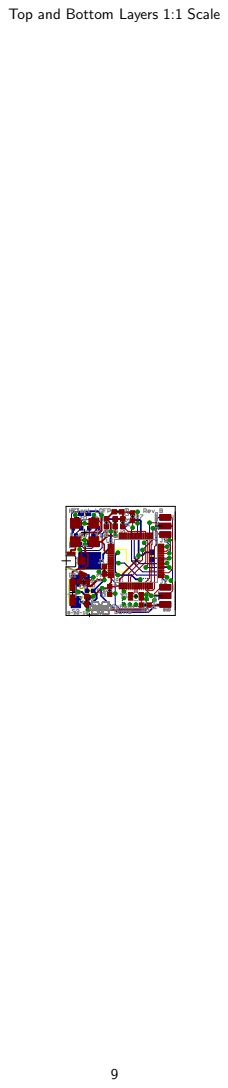
[picture p78: page 9]

Top and Bottom Layers 1:1 Scale

Top Layer 1:1 Scale

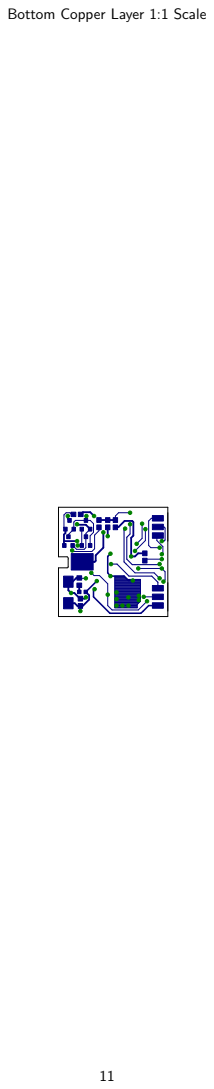
[picture p79: page 11]

Bottom Copper Layer 1:1 Scale
