lab11/hijack/hardware/hijack/rev_c/HIJACK_LQPF_C.pdf

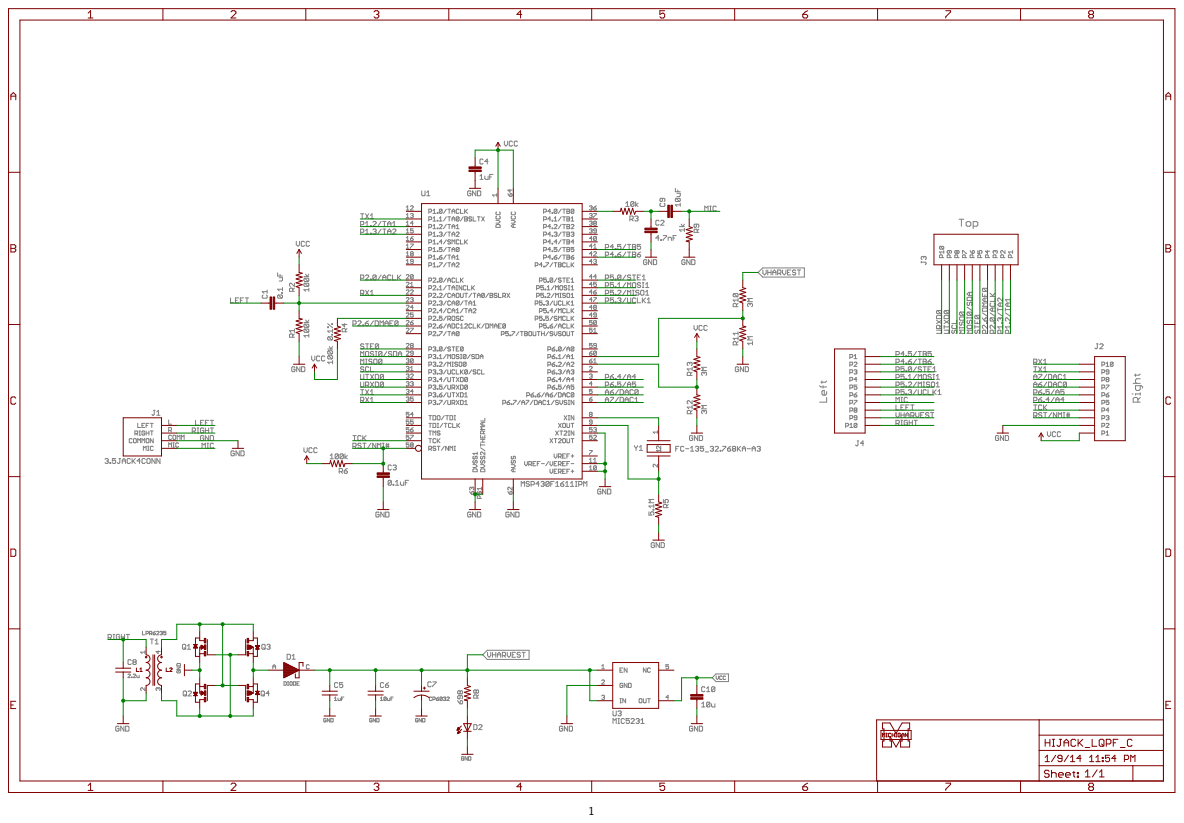
[picture p80: page 1]

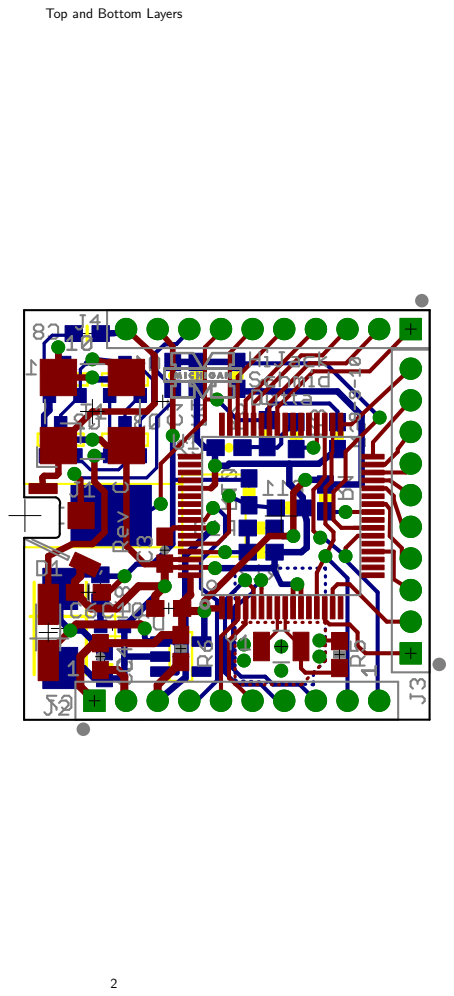
[picture p81: page 2]

Top and Bottom Layers

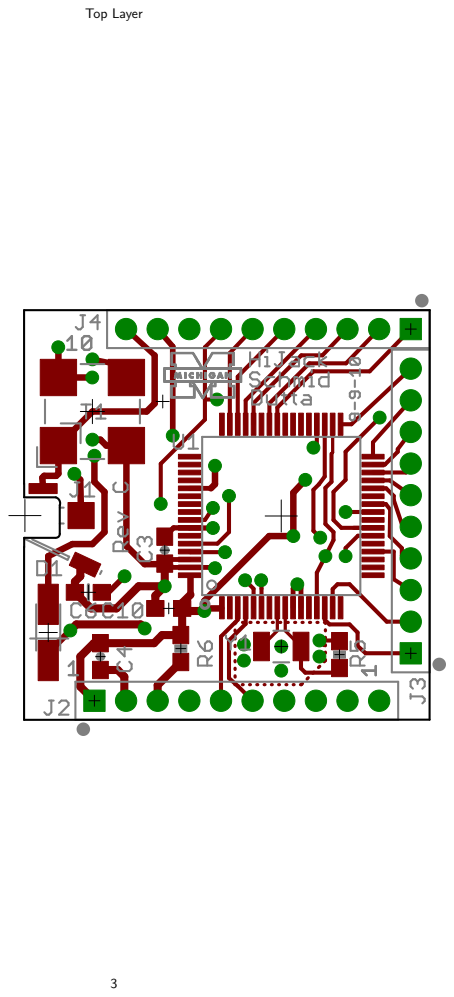
[picture p82: page 3]
Top Layer

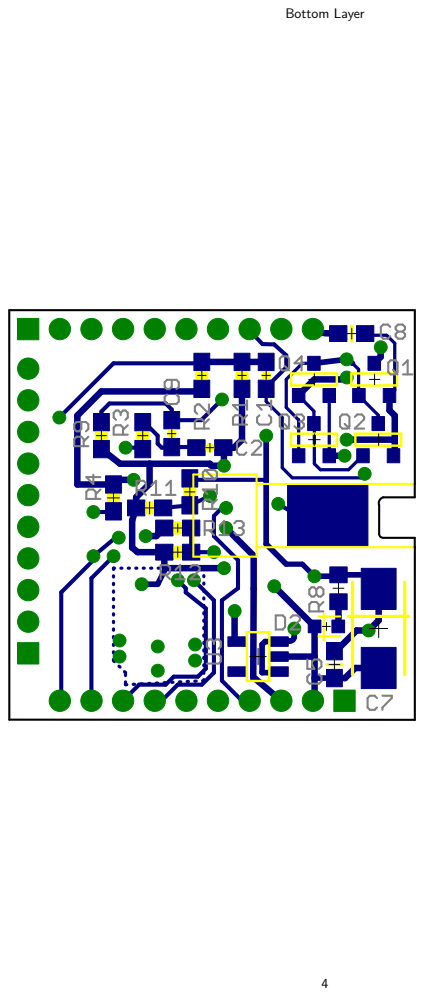
[picture p83: page 4]
Bottom Layer

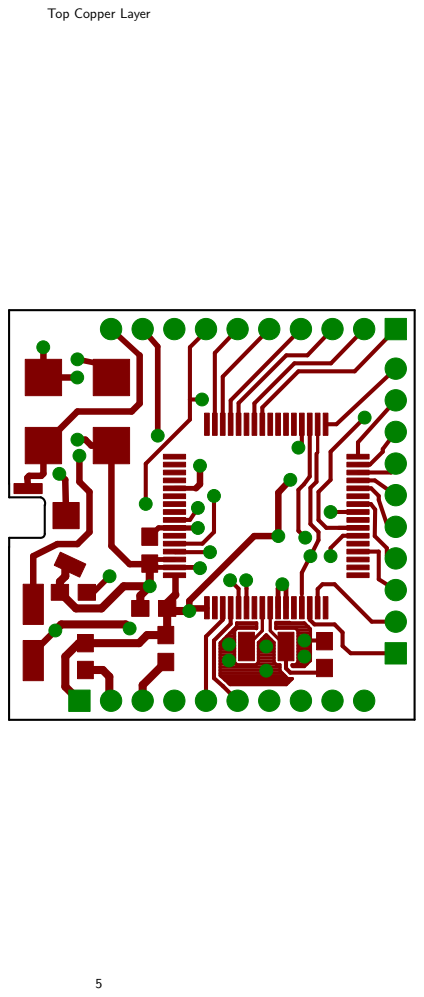
[picture p84: page 5]

Top Copper Layer

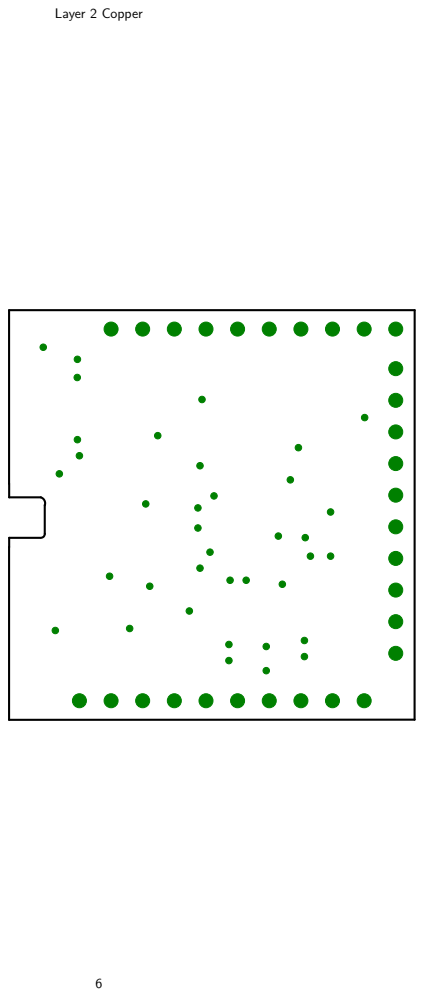
[picture p85: page 6]
Layer 2 Copper

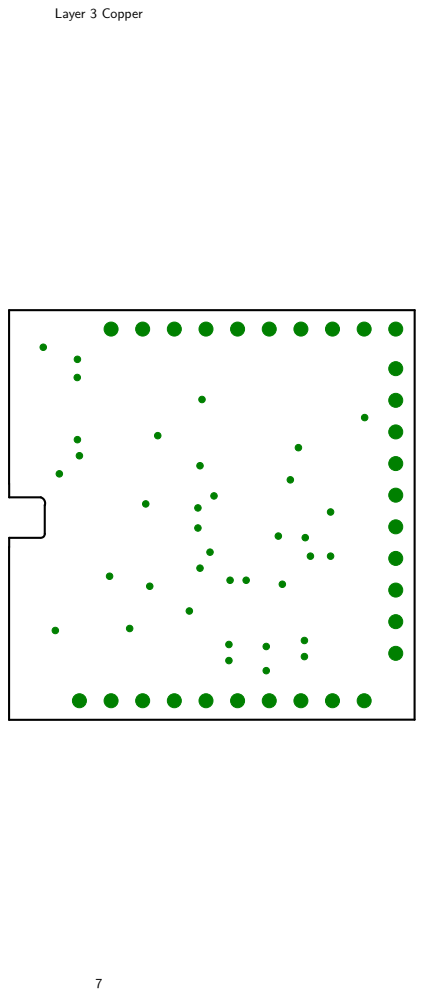
[picture p86: page 7]
Layer 3 Copper

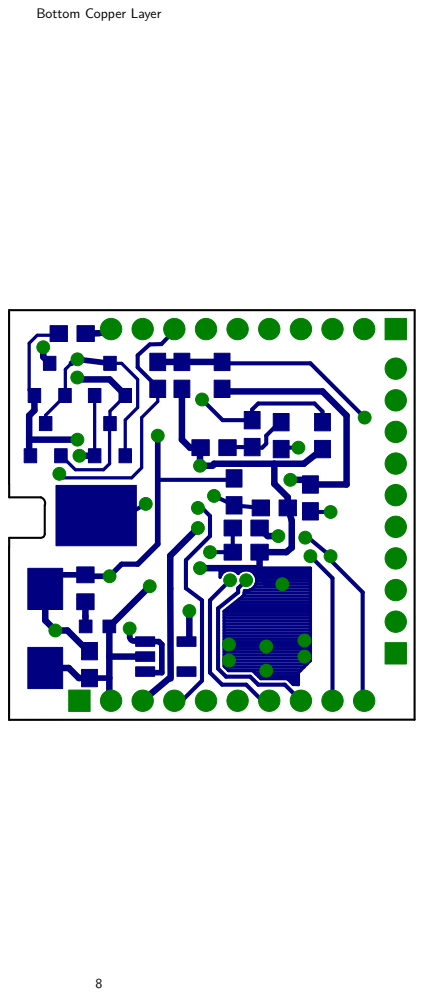
[picture p87: page 8]

Bottom Copper Layer

Top Paste Layer with Silkscreen

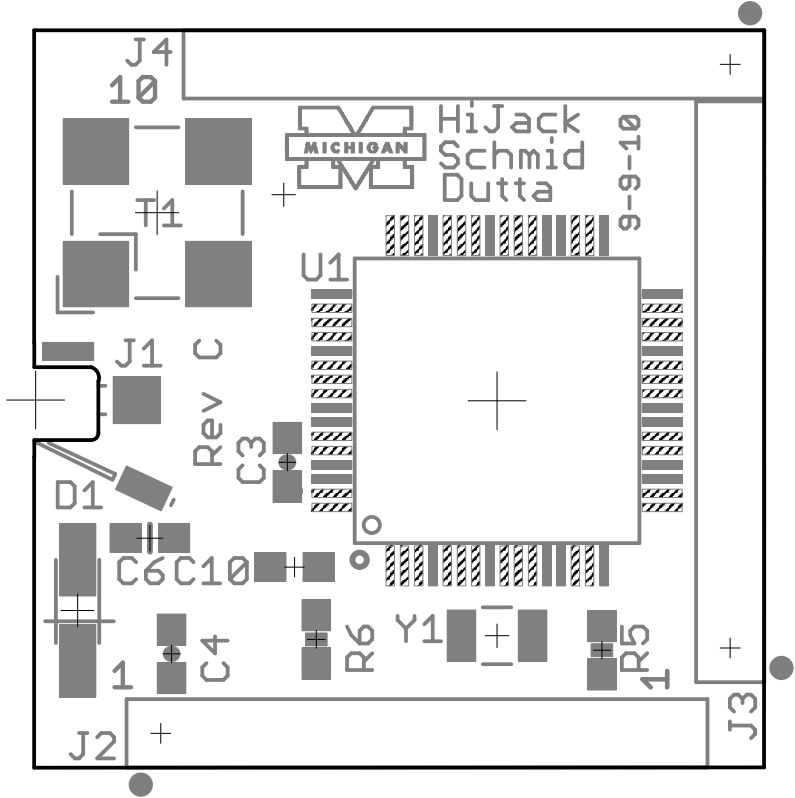
[picture p88: figure]

Bottom Paste Layer with Silkscreen

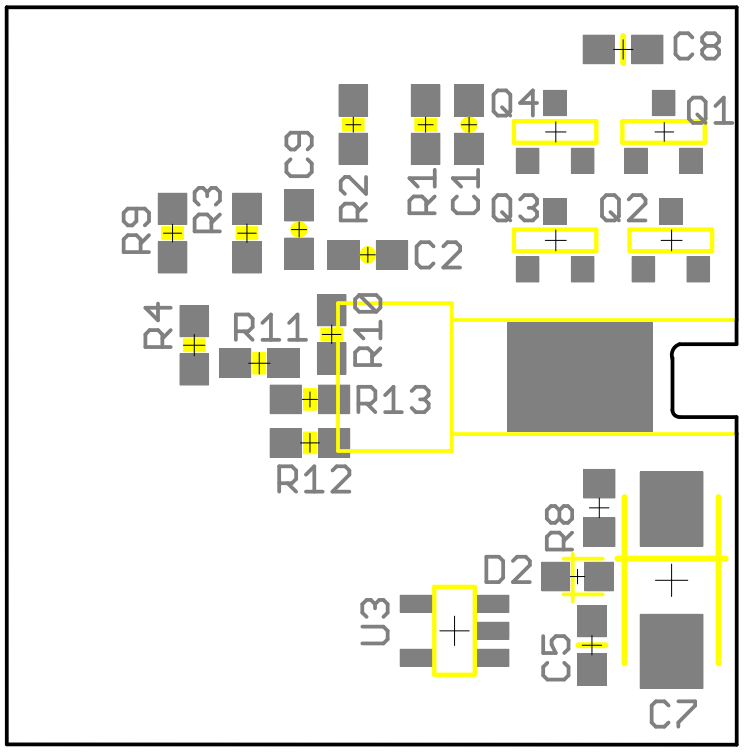
[picture p89: figure]
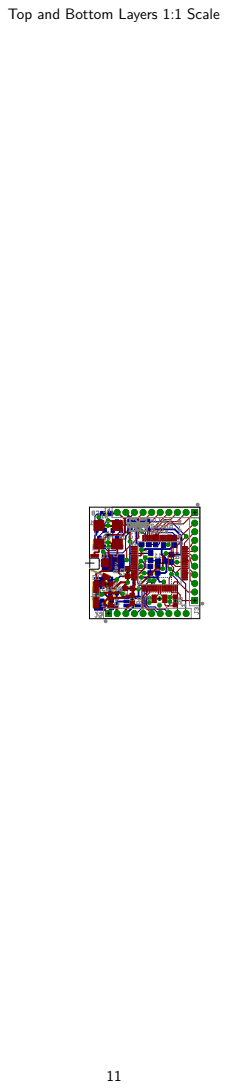
[picture p90: page 11]

Top and Bottom Layers 1:1 Scale

Top Layer 1:1 Scale

Layer 2 Copper 1:1 Scale

Layer 3 Copper 1:1 Scale

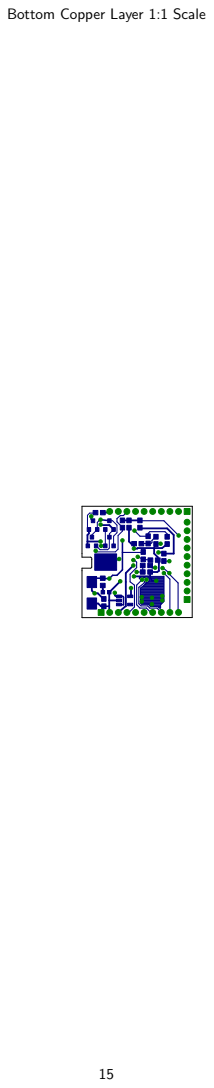
[picture p91: page 15]

Bottom Copper Layer 1:1 Scale
