lab11/hijack/hijack/src/include/codingStateMachine.h

/*
 *  This file is part of hijack-infinity.
 *
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
 *  You should have received a copy of the GNU General Public License
 *  along with hijack-infinity.  If not, see <http://www.gnu.org/licenses/>.
 */

#ifndef __CSM_H__
#define __CSM_H__

#include "config.h"

#include <inttypes.h>

////////////////////////////////////////
// Public Members:
////////////////////////////////////////

// Struct to pass capture data to the receive timing function.
typedef struct csm_timer_struct {
	uint16_t elapsedTime;  // Timer counts between this and the last value
	uint8_t  signal;       // If the signal line is low or high
} csm_rx_input_t;

// Definition of callback function to be called when a packet has been received.
typedef void csm_bufferReceived (uint8_t*, uint8_t);

// Definition of callback function to be called when a buffer has been sent.
typedef void csm_bufferSent (void);

// Called by higher software, will send the passed in packet to the phone.
// Returns 1 if already transmitting.
uint8_t csm_sendBuffer (uint8_t* buf, uint8_t len);

// Registers a callback function to be executed when a packet buffer has been
// received.
void csm_registerReceiveCallback (csm_bufferReceived* func);

// Registers a callback function to be executed when a packet buffer has been
// transmitted.
void csm_registerTransmitCallback (csm_bufferSent* func);

// Initializes the coder's state.
void csm_init(void);


////////////////////////////////////////
// Interrupts:
////////////////////////////////////////

// Receives a pair of timing data and current line signal data from the
// comparator.
void csm_rxEdgeInterrupt (uint16_t elapsedTime, uint8_t isHigh);

// Receives an interrupt from the tx timer
void csm_txTimerInterrupt (void);


////////////////////////////////////////
// Private Memebers:
////////////////////////////////////////

typedef void    csm_rxDispatchFunc(void);
typedef uint8_t csm_txDispatchFunc(void);

typedef enum csm_transmitStateEnum {
	CSM_TXSTATE_IDLE,
	CSM_TXSTATE_PREAMBLE,
	CSM_TXSTATE_START,
	CSM_TXSTATE_DATA,
	CSM_TXSTATE_POSTAMBLE,
} csm_txState_e;

typedef enum csm_receiveStateEnum {
	CSM_RXSTATE_IDLE,
	CSM_RXSTATE_DATA,
	CSM_RXSTATE_DATA_EXTRA
} csm_rxState_e;

typedef enum csm_receiveBits {
	CSM_RX_BIT_DIFFERENT,
	CSM_RX_BIT_SAME
} csm_receiveBitType_e;

#define MAX_BUF_SIZE    128
#define RX_PREAMBLE_LEN 7

#define START_BIT    0
#define IDLE_BIT     0
#define PREAMBLE_BIT 1

// Keep all the state associated with this module
// in a struct.
struct csm_state_struct {

	/// State

	csm_txState_e txState;
	csm_rxState_e rxState;

	// Set to 1 if we are currently transmitting a packet
	uint8_t transmittingPacket;

	// Whether the mic pin is configured as an output or input
	uint8_t txPinOutput;


	/// TX

	// Storage for the raw, fully-formed packet from the upper layer that is to
	// be transmitted
	uint8_t txBufRaw[MAX_BUF_SIZE];
	// Length of the raw out buffer
	uint8_t txLen;
	// Which byte from the raw buffer we are currently transmitting
	uint8_t txByteIdx;
	// Which bit of the byte we are transmitting
	uint8_t txBitIdx;
	// Which half of the manchester bit we are sending
	uint8_t txBitHalf;
	// How many bits to send in the preamble
	uint8_t preambleBitLen;
	// How long should the mic line be held low after a packet
	uint8_t postambleBitLen;

	// The value to set on the pin the next time the txTimerInterrupt fires.
	// By using this we can determine what the pin should be in advance, and
	// then immediately update the pin when the timer fires.
	uint8_t txPinVal;

	/// Callbacks
	// Called after a buffer has been sent
	csm_bufferSent* txCallback;


	/// RX

	// Timing of two consecutive edges (single baud)
	uint16_t rxDeltaT;
	uint16_t rxThreshold;

	// Buffer to hold the last four elapsed time between edges. If these are all
	// about the same, and then we get a double length elapsed time at a rising
	// edge, then we have detected a start bit to a packet.
	uint16_t rxPreambleBuffer[RX_PREAMBLE_LEN];
	uint8_t  rxPreambleReceivedEdges;
	uint8_t  rxPreambleIdx;

	// Buffer to put the raw data read from the phone in
	uint8_t  rxBufRaw[MAX_BUF_SIZE];
	// Number of bits received for this byte
	uint8_t  rxBitIdx;
	// Total number of bytes received
	uint8_t  rxByteIdx;
	// The value of the last bit we added to the array
	uint8_t  rxPreviousBit;

	// RX Callback triggers when a packet has been received
	csm_bufferReceived* rxCallback;

} csm;

// PRIVATE METHODS:

// Receive state machine dispatchers
void csm_receiveIdle(uint16_t elapsedTime, uint8_t isHigh);
void csm_receiveData(uint16_t elapsedTime, uint8_t isHigh);
void csm_receiveDataNext(uint16_t elapsedTime, uint8_t isHigh);

void csm_receiveClear ();
void csm_receiveAddBit (csm_receiveBitType_e bit);

// Helper functions
uint8_t csm_isWithinThreshold(uint16_t value, uint16_t desired);
inline uint8_t csm_int2man (uint8_t val);

#endif
