lab11/hijack/(commit log)

2013-06-18 Issue with periodic packets - byte checksum fails
    [main.c]
2013-06-21 looks good to me, doesn't work with android app
    [codingStateMachine.c, codingStateMachine.h, f1611_timer.c, framingEngine.c, framingEngine.h, main.c]
2013-06-24 new packet format from mcu to phone
    short preamble, then header byte, then data, then checksum
    length is determined by counting the number of bits received.
    no more of this picking bytes out of a constant stream
    [codingStateMachine.c, codingStateMachine.h, f1611_timer.c, framingEngine.c, main.c]
2013-07-12 Added hijack hardware
    [HIJACK_LQPF_D.brd, HIJACK_LQPF_D.sch, HiJack_BOM.xls]
2013-07-12 added gerbers and such
2013-12-08 many changes trying to get bidirec data working
    having problems with reading on the phone STILL
    [codingStateMachine.c]
2013-12-09 WORKS WITH HTC ONE
    without usb power
2013-12-11 adding callbacks to hijackio
    not sure how to do two things:
    1. convert base Packets to HiJackIOPacket
    2. setup the callbacks. if there are multiple things setting and
    querying the digital io, they shouldn't all get callbacks when a digital
    pin state packets comes back, only the thing that asked for the state
2014-01-10 added case
    [M.skp, case v1.skp, case_v2.skp, case_v3.skp, case_v3.stl, case_v4.skp, case_v5.skp, case_v6.skp]
2014-01-10 added hijack programmer
    [HiJack_Programmer.brd, HiJack_Programmer.sch, HiJack_Programmer_bom.csv, HiJack_Programmer_bom.xls]
2014-01-10 added hijack protoboard
    [HiJack_ProtoBoard.brd, HiJack_ProtoBoard.sch]
2014-01-10 added hijack power supply rev a
    [HIJACK_A.brd, HIJACK_A.sch]
2014-01-10 hijack rev c
    [HIJACK_LQPF_C.brd, HIJACK_LQPF_C.sch]
2014-01-10 hijack rev b
    [HIJACK_LQPF_B.brd, HIJACK_LQPF_B.sch]
2014-01-10 hijack rev a
    [HIJACK_LQPF_A.brd, HIJACK_LQPF_A.sch]
2014-01-10 old hijack rev b (rev a)
    [HIJACK_B.brd, HIJACK_B.sch]
2014-01-10 hijack old rev c/b
    [HIJACK_C.brd, HIJACK_C.sch]
